akiihito/expresslrs_realtime_recorder/hardware/README.md

# 回路図 / 基板（KiCad 9）

`recorder.kicad_pro` を KiCad で開く。KiCad無しで見る／印刷する用に
`recorder.pdf`（回路図）と `pcb-fab.pdf`（基板の表面・1:1）。

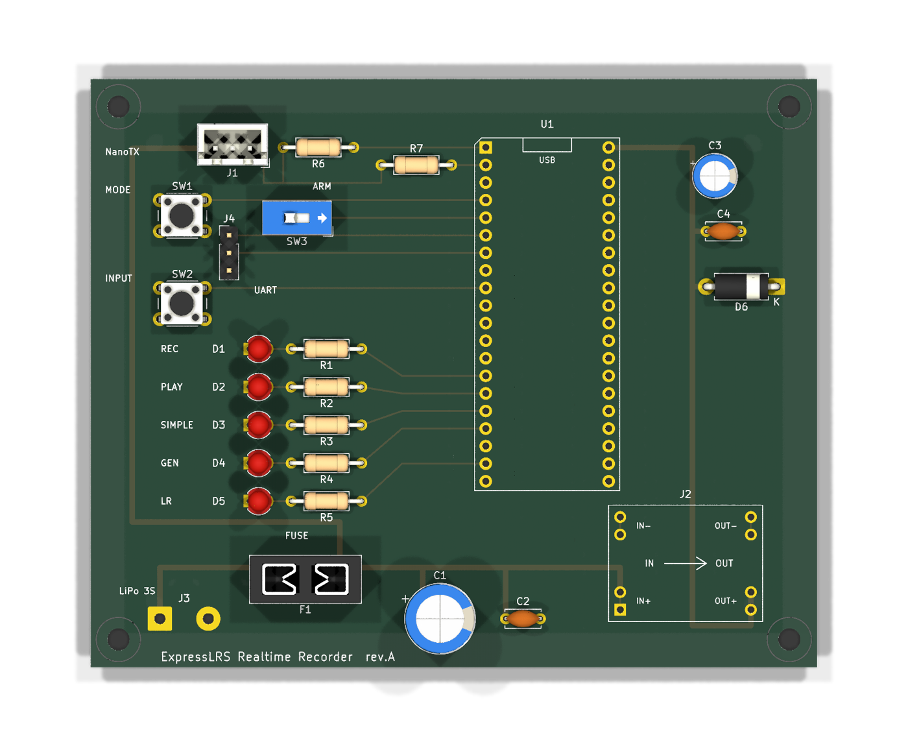
[picture p1: hardware/pcb-top.png]
基板


## 基板の概要

- **105 × 85 mm / 2層 / 全てスルーホール**（初めての基板をハンダ付け1工程で組めるように）
- **裏面は全面GNDベタ**。全部品がスルーホールなのでGNDパッドはベタに直結し、
  GND用の配線もビアも1本も無い。表面の信号配線は**ビア0**。
- Picoの**左列に繋がる部品は左側、右列(VBUS)は右側**に置き、Picoを跨ぐ配線を無くした。
  さらに左側の部品は**Picoのピンと同じY座標**に並べてあるので、配線は水平一直線で
  交差しない。

## 検証状況

| 対象 | 結果 |
|---|---|
| 回路図 ERC | **エラー0 / 警告0** |
| ネットリスト | 全ネットの結線を目視ではなく機械的に突き合わせ済み |
| 基板 DRC | **違反0 / 未配線0**（ゾーン塗りつぶし後） |
| ガーバー出力 | 正常（`kicad-cli pcb export gerbers`） |

生成スクリプトは配線の端点が「同ネットのパッド上」か「同ネットの別配線上」の
どちらかであることを出力前に自己検査する（座標の打ち間違い防止）。

> ⚠️ **実基板は未発注・未検証**。ブレッドボードで動作確認済みの回路を起こしたもので、
> DRCが通っていることと実際に動くことは別。発注前に下記「発注前チェック」を必ず実施。

## ネット一覧（`kicad-cli sch export netlist` の結果）

| ネット | 接続先 |
|---|---|
| `+5V` | J2.3 (Buck OUT+) — U1.40 (VBUS) — C3 — C4 — D6 |
| `VBAT_7_13V` | F1 (ヒューズ出力) — J2.1 (Buck IN+) — J1.3 (Nano TX VBAT) — C1 — C2 |
| （J3.1〜F1） | LiPo+ はヒューズ F1 を通ってから VBAT_7_13V へ |
| `GND` | 全GND（Pico 8本, J1〜J4, SW1〜3, D1〜D5） |
| `CRSF_TX` | U1.1 (GP0) — R6.1 (680Ω) |
| `CRSF_BUS` | R6.2 — J1.1 (Nano TX CRSF) — R7.1 |
| （R7〜GP1） | GP1 は保護抵抗 R7(1kΩ) を介してバスへ |
| `DBG_TX` / `DBG_RX` | U1.6 (GP4) / U1.7 (GP5) — J4.1 / J4.2 |
| `BTN_MODE` | U1.4 (GP2) — SW1 |
| `BTN_INPUT` | U1.9 (GP6) — SW2 |
| `SW_ARM` | U1.5 (GP3) — SW3 |
| `LED_REC` / `LED_PLAY` / `LED_SIMPLE` | U1.14/15/16 (GP10-12) — R1/R2/R3 |
| `LED_GENERIC` / `LED_LITERADIO` | U1.17 (GP13) / U1.19 (GP14) — R4 / R5 |

## ブレッドボードとの違い（要判断）

- **GP1 を CRSF バスに接続している。** ブレッドボードでは GP0 のみ配線して
  Stage D に合格したが、ファームの `crsf_drain_telemetry()` は「半二重で自分の
  送信エコーがRXに入る」前提で書かれており、参照図（63bit氏 R63b）も TXD/RXD を
  1本に結線している。基板ではその形に合わせた。**不要なら J1.1 と GP1 の間を
  切れるようにしておくと安全。**
- **SW3（GP3 の Arm トグルスイッチ）を載せている。** ファーム側の実装は
  commit `1534582` にあるがスイッチ未購入のため revert 中（`eb4c241`）。
  基板には場所を用意しておく方が後で楽なので含めた。

## 部品

PCB版・ユニバーサル基板版で共通（同じ参照記号・同じ部品を使う）。
**寸法とピッチはPCBのフットプリント＝実物の寸法**なので、買う時はこの列を見ること。
「秋月」列は秋月電子通商の販売コード（6桁の新形式。旧 `P-xxxxx` ではない）で、
**2026-10-27 にカタログで確認**した。`—` は秋月に無いもの。

| 参照 | 個数 | 買うもの | 秋月 | 寸法・ピッチ | 備考 |
|---|---|---|---|---|---|
| U1 | 1 | Raspberry Pi Pico（**ヘッダ付きの Pico H** が楽） | — | 2×20 / 2.54mm | メスヘッダに載せる想定（書込み時に外せるように）。USBポートはゲームパッド専有 |
| R1–R5 | 5 | カーボン抵抗 1/4W **100Ω** | `125101` | 軸型・足間10.16mm（2.54mm×4） | LED直列。緑/青はVf≈3Vで330Ωでは暗い。約13mAなので気になれば150Ω。100本袋しか無い |
| R6 | 1 | カーボン抵抗 1/4W **680Ω** | `125681` | 同上 | CRSF半二重バスの保護（衝突時の電流制限） |
| R7 | 1 | カーボン抵抗 1/4W **1kΩ** | `125102` | 同上 | GP1の保護。J1逆挿し時に13Vが直でGPIOへ入るのを防ぐ |
| D1 | 1 | **3mmφ** LED **赤** | `112608` | φ3.0・足2.54mm | RECORD |
| D2 | 1 | **3mmφ** LED **緑** | `111635` | 同上 | PLAYBACK |
| D3 | 1 | **3mmφ** LED **青**（秋月は青緑505nmで代用） | `112719` | 同上 | SIMPLE。⚠️ 3mmの純青は秋月では100個入りしか無い。5mm青でも手組みなら足は2.54mmで入る |
| D4, D5 | 2 | **3mmφ** LED **任意色**（黄を想定） | `111639` | 同上 | 入力プロファイル表示。赤緑青はモード表示で使い切っているので別の色にする |
| D6 | 1 | 双方向TVSダイオード **P6KE6.8CA**／秋月は **P4KE6.8CA**(400W, standoff 5.8V) | `129631` | DO-15軸型・足間10.16mm | 5Vレール。Buck短絡故障・活線挿抜サージ対策。双方向なので極性不問。⚠️ **SMD品(SMAJ5.0CA等)はこの基板に載らない**。型番の数字は降伏電圧なので「5V品」は存在しない（standoffが5.5〜5.8V＝5Vレール用） |
| SW1, SW2 | 2 | **6mm角** 基板用タクトスイッチ（4本足） | `103647` | 6×6mm・足間6.5×4.5mm | モード切替 / 入力切替。内部プルアップ使用。**対角の2本**を使う（同じ側の2本は内部で繋がっている）。⚠️ 足間が2.54mmの倍数でないので、手組みでは7.62×5.08mmに曲げて挿す |
| SW3 | 1 | 基板用 **スライドスイッチ SPST**（1回路2接点） | `115707` | 基板は7.62mm・2端子 | Arm。位置が目視できれば形状は自由（本文では「トグルSW」とも呼んでいる）。**部品待ち**。⚠️ 秋月のSS-12D00G3は3端子2.5mmピッチで**PCBのフットプリントには合わない**（手組みなら中央＋片端の2本を使えば可） |
| J1 | 1 | **JST XHコネクタ 3P**：ベース／ハウジング／コンタクト | `112248`／`112256`／`112264` | 2.5mmピッチ | Nano TX V2（背面視 左から CRSF/GND/7-13V）。**キー付きにする**（逆挿しで最大13VがCRSF線に乗る）。コンタクトは10個入り |
| J2 | 1 | **MP1584EN** 可変降圧モジュール | — | 22.3×16.8mm / 穴間隔18.9mm | **Amazon/AliExpress**（秋月に無い）。穴が2.54mmの倍数でないので手組みではリード線で接続。⚠️ 繋ぐ前に単体で5.0Vに調整 |
| J3 | 1 | LiPo側コネクタ付きピグテール（**XT30**が有力・実機で要確認） | — | 基板は足間7mmの直付けパッド | **ホビーショップ/Amazon**。**送信側（地上側）の電源で、機体に積むパックとは別物**。3Sで確定（2026-10-27）。手持ちのパックとコネクタを揃えれば充電器を共用できる。⚠️ **極性キー付きのものだけ**使う。ネジ端子・素のピンヘッダは不可 |
| J4 | 1 | 2.54mm ピンヘッダ 1×40（切って使う） | `100167` | 2.54mm | USB-シリアル変換（TXD/RXD/GND） |
| F1 | 1 | ヒューズホルダ＋**2A**ヒューズ | 下記参照 | 下記参照 | LiPo+主線。**定格は実測して決める**（2Aは初期値）。⚠️ **遅動(タイムラグ)品が秋月で確認できていない** — 速断型は投入時の突入電流で飛ぶ恐れがある（`107130` は B種とだけ表記）。ホルダの選択肢は下表 |
| C1 | 1 | 電解コンデンサ **470µF/25V** | `117883` | φ10mm・足間5.0mm | Nano TX VBAT直近。送信バーストの電圧ドロップ対策。⚠️ 秋月品はφ8mm/3.5mmピッチなのでPCBでは足を少し広げる |
| C2, C4 | 2 | セラミックコンデンサ **100nF(0.1µF)** | `112670` | φ5mm・足間5.0mm | 高周波側。C2はJ1近く、C4はPicoのVBUS近く。⚠️ 秋月品は2.54mmピッチなのでPCBでは足を広げる |
| C3 | 1 | 電解コンデンサ **100µF/16V** | `105002` | φ6.3mm・足間2.5mm | Pico VBUS直近。ゲームパッド接続時の突入電流対策 |
| H1–H4 | 4 | M3ネジ・ナット・スペーサ | — | 穴φ3.2mm | 取付穴（PCB版のみ） |

⚠️ 電解コンの耐圧は**3S満充電12.6Vを超えること**（C1は25V品）。極性に注意。
C1〜C4は回路図上は電源ラベルで繋いでいるだけなので、**PCBでは必ず対象の直近に配置**すること

#### F1 ヒューズホルダの選択肢（2026-11-03 にデータシートで確認）

| 方式 | 秋月 | 足のピッチ・太さ | PCB版 | ユニバーサル基板版 |
|---|---|---|---|---|
| ミニ平型（基板図のフットプリント） | `118222` ¥480＋ヒューズ | φ1.78mm・9.92×3.4mm | ◎ そのまま | ✗ 穴に入らない |
| ガラス管ミゼット用クリップ **2個で1組** | `110521` ×**2** ＋ `107130`(5.2×20mm 2A) | φ1.7mm・足間6.7mm | △ フットプリント別途 | ✗ 穴に入らない |
| **配線用（インライン）** | — | 線のまま | — | ◎ **手組みはこれ** |

ユニバーサル基板の穴はφ約1mmなので、**基板取付品はどちらも挿さらない**（ピッチも
2.54mmの倍数でない）。手組みでは配線用ホルダを LiPo+ の線に割り込ませる
（[`docs/perfboard.html`](../docs/perfboard.html) の「部品ごとの注意」参照）。
ミニ平型のヒューズ本体は**カー用品店の自動車用ミニ平型2A**が入手しやすい。

（離して置くと効果がない）。

### ユニバーサル基板で組む場合の追加品

| 買うもの | 秋月 | 備考 |
|---|---|---|
| ユニバーサル基板 | `113156` | 両面スルーホール 8cm×12cm。必要な穴数は [`docs/perfboard.html`](../docs/perfboard.html) 参照。7cm×9cm（`113155`）はジャストサイズ。⚠️ **カタログ寸法と穴数は別物**で、秋月もサンハヤトも穴数を公表していない（95×72mmで30×25穴の製品が実在する）ので、サイズだけで選ばないこと |
| ピンソケット **1×20** を**2本** | `103077` ×2 | U1を抜き差しできるように（書込みのたびに外す）。⚠️ **2×20品は使えない** — Picoの2列は17.78mm(7穴)離れているので、2.54mm間隔の2列品では入らない |
| 配線用ヒューズホルダ＋2Aヒューズ | — | F1。基板取付品は穴に入らないので手組みはこちら（上記「F1 ヒューズホルダの選択肢」）。カー用品店／Amazonのミニ平型インラインホルダが手早い |
| 配線材（信号） | `109583` | ポリウレタン銅線 2UEW 0.29mm 20m。**28区間のうち18区間が被覆必須**で、その大半がこれ（[`docs/perfboard.html`](../docs/perfboard.html)「配線リスト」の「線」列） |
| 配線材（裸線） | — | **すずメッキ線 φ0.6mm**。GND母線6本と、配線5区間。⚠️ **母線は抵抗の切った足では足りない** — Cは23穴=58mm、Fは24穴ある |
| 配線材（電源） | — | **AWG24程度の被覆線**。5区間（VBAT 4本とヒューズ前のLiPo+） |

**秋月ぶんの概算は約¥1,430**（2026-10-27時点・Pico/Nano TX/ゲームパッド/LiPoを除く）。
抵抗が100本袋単位なので、その¥400が効いている。

上表の J1〜J4 は、手組みでは2.54mmピンヘッダで代用してもよい（J1だけは逆挿し対策で
キー付きコネクタを推奨）。J2とF1は足のピッチが2.54mmの倍数でないので、どちらにせよリード線になる。

## 再生成について

`tools/gen_sch.py` が KiCad 標準ライブラリからシンボルを取り出して
`recorder.kicad_sch` を生成する（配線はネットラベル方式）。

```bash
cd hardware/tools && python3 gen_sch.py ../recorder.kicad_sch
```

⚠️ **再生成すると KiCad の GUI で加えた編集は失われる。** 一度 KiCad で
編集を始めたら、このスクリプトは「どう作ったかの記録」として扱うこと。

## 設計レビューで挙がった注意点（2026-08-27）

回路図を一通り見直して出た項目。**対策済み**と**運用/レイアウトで対応**に分かれる。

### 対策済み（部品を追加した）

| 想定する故障 | 対策 |
|---|---|
| LiPoショート → 発火 | **F1** ヒューズ（LiPo+主線） |
| TX送信時の電圧ドロップ | **C1/C2**（VBATレール） |
| ゲームパッド接続時の突入電流 | **C3/C4**（5Vレール） |
| Buck短絡故障で12Vが5Vへ／活線挿抜サージ | **D6** TVS |
| J1逆挿しで13VがGP1直撃 | **R7** 1kΩ（GP0側は既存のR6 680Ω） |

### ⚠️ 部品では解決できない・運用で守る項目

- **J3(LiPo)の逆接続**。回路的な逆接続保護は入れていない。ただし標準的なLiPoコネクタ
  （XT30/XT60, Deans, JST-RCY, PH2.0/BT2.0 等）はすべて極性キー付きで、**差し込む時点で
  逆にはならない**。残るリスクは**基板側の実装ミス**（コネクタを逆向きにハンダ付けする、
  ピグテールの赤黒を逆に配線する）のみ。
  - 対策: **初回通電前にテスターでJ3の極性を確認**する。ここだけは目視ではなく実測。
  - 極性キーのないもの（ネジ端子・素のピンヘッダ）は使わない。
- **J1(Nano TX)の逆挿し**。3ピンで、逆に挿すとVBAT(最大13V)がCRSF線に乗る。
  R6/R7で電流は制限されるがGPIOには良くない。**キー付きコネクタにして、
  シルクに向きを大きく印刷**すること。
- **D6はPicoの延命を保証しない**。TVSのクランプ電圧(P6KE6.8CAで約10.5V)はPicoの絶対最大定格
  5.5Vより高いので、Buck短絡時にPicoは壊れる可能性が高い。D6の役目は
  「12Vが載り続ける状態を断ってヒューズを飛ばす」こと。
- **F1の2Aは暫定値**。実消費電流を測ってから決めること（測り方は下記）。
  過大だと保護にならず、過小だと送信時に飛ぶ。
- **LEDの電流は約13mA**（赤, 100Ω）で、RP2040のドライブ設定(既定4mA/最大12mA)を
  わずかに超える。パッドの電圧が垂れて自己制限されるため実用上は問題なく、
  ブレッドボードでも動作しているが、気になるなら150Ωへ。

### 実測が必要な項目（レイアウト前に確定させる）

| 項目 | 理由 |
|---|---|
| ~~送信側LiPoのセル数~~ | **決着（2026-10-27）: 3S**。2Sは放電末期に7VでNano TXの下限に触れる。満充電12.6Vも上限13Vの内側で、ブレッドボードで使ってきた12V電源装置とほぼ同じ条件になる |
| **LiPo側コネクタの型** | J3のフットプリント選定に必要。3Sパックを買う時に決まる（XT30想定）。手持ちパックに合わせるかは運用の判断で、電気的には極性キー付きなら何でもよい |
| **降圧モジュールの実寸・ピッチ** | 同型番でも製品差がある。ノギスで実測 |
| **地上側の消費電流** | F1のヒューズ定格を決めるため（下記） |

#### 消費電流の測り方 → ヒューズ定格

> ⚠️ **「Arm時」で測るのは誤り**。Armで増えるのは*機体側*のモーター電流で、機体の
> バッテリーから出ている。F1が守るのは**地上側（Pico＋Nano TX）**で、こちらはArm状態に
> 関係なく常時500Hzで送信しているため電流はほぼ一定。

支配的なのは **Nano TXの送信出力設定**（25mW〜1000mW）。次いでゲームパッドの消費とLED。
なので測るのは「**実際に使う設定での最大**」。

- **一番簡単**: ブレッドボード検証で使っている**安定化電源の電流表示を読む**。
  回路を切らずに済む。12Vを入れ、機体とリンクさせた状態で読む。
- **テスターの場合**: 電流モード（**10Aジャック**。mAジャックはテスター内蔵ヒューズが飛ぶ）で
  **LiPo+の線に直列**に入れる。まさにF1が入る位置。

測る条件: ①TXのみ ②ゲームパッド接続＋LED点灯 ③**TX出力を実際に使う最大**に設定。

定格は測定した最大の **1.5〜2倍**を標準値から選ぶ。**遅動(スローブロー)を選ぶこと** —
Buck入力コンデンサへの突入電流で、速断型だと投入のたびに飛ぶ恐れがある。

テスターもPSUも平均値表示だが、**ヒューズは熱で切れるので瞬間のピークでは飛ばない**。
平均値＋余裕で選べばよい。

> ⚠️ **電源装置が繋がっている今のうちに測る**。LiPoに移ってからだとテスターを直列に
> 入れる手間が増える。1回の測定で**ヒューズ定格とパック容量（電流×飛行時間×余裕）**が
> 同時に決まる。

#### 電源装置からLiPoに移る時が、F1が必要になる瞬間
電圧は3S（満充電12.6V）で12V電源装置とほぼ同じだが、**電流の出方が違う**。

- **電流制限が無くなる**。電源装置には制限があるので、配線ミスでショートしても頭打ちに
  なって守られていた。LiPoは内部抵抗が低く**数十A出る**。F1が「あった方がいい部品」から
  **必須部品**に変わるのはこの切り替えのタイミングで、それ以前のブレッドボード検証で
  問題が出ていなかったことは根拠にならない。
- **突入電流が大きくなる**。Buck入力コンデンサを充電する瞬間の電流がPSUより大きく出る。
  これが上記「遅動を選ぶこと」の理由。

### PCBレイアウト時に効く項目

- **裏面はGNDベタ**にする（スター結線を線で再現しない方が良い。詳細はCLAUDE.md参照）。
- **C1/C2はJ1の足元、C3/C4はU1のVBUSピンの足元**に置く。離すと効果が消える。
- **VBAT/+5V/GNDは太いトラック**（`recorder.kicad_pro` の `Power` ネットクラス 0.8mm）。
- **テストポイントを置く**: +5V / VBAT / GND / CRSF。デバッグが楽になる。
- **U1のUSB端子は基板端へ**。ゲームパッドのケーブルが挿さる向きに。
- **取り付け穴**を忘れない。

## 発注前チェック（必須）

### ⚠️ 実測で確定させる項目（部品が手元に戻ったら）

| 項目 | なぜ必要か |
|---|---|
| ~~降圧モジュール~~ | **対応済み**。購入品 MP1584EN 用のフットプリントを作成（下記） |
| **LiPoコネクタ** | J3は**ピグテールを直付けするパッド**にしてある。送信側は3S（XT30想定）。XT30等をコネクタで付けたい場合はJ3を差し替え |
| **ヒューズ定格** | F1はミニ平型ヒューズホルダ。定格は実測して決める（本文の測り方参照） |
| **SW1/SW2 の内部結線** | ⚠️ 下記。発注前にテスターで確かめる |

#### ⚠️ SW1/SW2 は「どの2本が内部で繋がっているか」を発注前に実測する

フットプリント `SW_PUSH_6mm` は **6.5mm離れた2本が同一端子**（pin1=(0,0)と(6.5,0)、
pin2=(0,4.5)と(6.5,4.5)）という前提で、PCBはその組を銅箔で繋いでいる。
**実物が逆（4.5mm側が同一端子）だと、挿した瞬間に2端子が短絡して「常時押されている」基板になる。**
フットプリントが6.5×4.5mmの長方形なので90°回しても逃げられない。

買ったスイッチの4本をテスターで当たり、**6.5mm離れた2本が常時導通**していることを
確認してから発注する。逆だった場合は `tools/gen_sch.py` のフットプリント指定を
`SW_PUSH_6mm_H5mm` 系の合うものに差し替えて再生成する。

> 手組み（ユニバーサル基板）では**対角の2本を使うので、どちらの向きでも問題にならない**。
> これが効くのはPCB版だけ。

### 手順

1. **`pcb-fab.pdf` を1:1で印刷し、実物の部品を載せて合わせる。**
   フットプリント違いは基板を1枚無駄にする最大の原因。**特にJ2**（寸法は商品写真からの
   画像解析であり、ノギス実測ではない）。8つの穴が実物と合うかを最優先で確認すること。
2. KiCadで **3Dビュー**を開き、部品の干渉とコネクタの向きを確認。
3. **DRCを製造業者の規格に合わせて再実行**（`recorder.kicad_pro` には
   最小クリアランス0.2mm / 最小線幅0.2mm を設定済み。JLCPCB等の標準で通る値）。
4. ガーバー出力:
   ```bash
   kicad-cli pcb export gerbers --output gerber/ hardware/recorder.kicad_pcb
   kicad-cli pcb export drill   --output gerber/ hardware/recorder.kicad_pcb
   ```

### 組み立て時の注意

- **J3の極性は初回通電前にテスターで実測**（コネクタは逆挿しできないが、実装ミスは起こる）。
- **電解コン(C1/C3)とLED(D1-D5)、TVS(D6)は極性あり**。シルクの向きに従う。
- **Picoの向き**: フットプリントのシルクに `USB` と角の面取りで pin1 側を示してある。
- Picoはメスヘッダに載せる想定（書き込み時に外せるように）。

## J2: MP1584EN 降圧モジュールのフットプリント

購入品（22.3×16.8mm、4隅に2穴ずつの計8穴）に合わせて `recorder.pretty/MP1584EN_Module`
を自作した。**寸法は商品写真を画像解析して求めた実測値**:

| 項目 | 値 |
|---|---|
| 基板サイズ | 22.3 × 16.8 mm |
| 穴の左右位置 | 中心から ±9.45 mm（測定値 9.35 / 9.52 の中間） |
| 穴の上下位置 | 中心から ±6.70 / ±4.16 mm（ペア間隔 2.54mm） |
| 穴径 / パッド | 1.0 / 1.7 mm |

ピン配置（**部品面から見て**）:

```
   IN-  ┌──────────────┐  OUT-
        │  IN  ──→ OUT │
   IN+  └──────────────┘  OUT+
```

裏面シルクは `OUT-(左上) IN-(右上) OUT+(左下) IN+(右下)` で、裏返すと左右が
入れ替わるため上記になる。部品面の ⊖/⊕ 表記が出力側にあることとも一致する。
回路図シンボル(Conn_01x04)との対応は `1=IN+ 2=IN- 3=OUT+ 4=OUT-`。

> ⚠️ **ノギスでの実測はしていない。** 誤差は最大0.1mm程度と見積もられ、穴径1.0mmなら
> 吸収できるはずだが、**発注前に `pcb-fab.pdf` を1:1印刷して実物を載せ、8穴が合うことを
> 必ず確認すること**。ズレていれば `tools/gen_buck_fp.py` の PAD_X / PAD_Y_OUT を
> 直して再生成する。

## 基板の設計判断

- **GNDはスター結線ではなくベタ**。CLAUDE.mdの「LiPo−起点のスター結線」は
  細い電線で組む前提の話で、基板ではベタの方がインピーダンスが桁違いに低く確実。
- **コンデンサは対象の直近に配置**: C1/C2はJ1(Nano TX)の足元、C3/C4はPicoのVBUSピンの
  足元。回路図上は等価でも、効果はレイアウトで決まる。
- **電源は太線(0.8mm)**、信号は0.25mm。
- **+5Vは基板を縦断する長い配線**（降圧モジュール→Pico VBUS, 約65mm）だが、
  0.6Aで電圧降下は約20mVなので問題ない。電流の大きいVBAT側を短くする配置を優先した。
- **J2は右下に配置**。VBAT(大電流)を短く、+5Vを基板縦断にする方針に加え、
  モジュール本体(22.3×16.8mm)がPicoと取付穴のどちらとも干渉しない位置がここだった。
- **U1のUSB端子は基板端から約8mm内側**。Picoはヘッダで約8mm持ち上がるのでケーブルは
  基板をまたげるが、気になるなら基板上端を数mm削ってもよい。

## 再生成について

```bash
cd hardware/tools
python3 gen_sch.py ../recorder.kicad_sch                      # 回路図
kicad-cli sch export netlist --format kicadsexpr -o net.net ../recorder.kicad_sch
python3 gen_pcb.py net.net ../recorder.kicad_sch ../recorder.kicad_pcb   # 基板
/Applications/KiCad/KiCad.app/Contents/Frameworks/Python.framework/Versions/3.9/bin/python3 \
    fill_zones.py ../recorder.kicad_pcb                       # ゾーン塗りつぶし
python3 gen_perf.py net.net ../../docs/perfboard.html         # ユニバーサル基板版
```

⚠️ `docs/perfboard.html` は `gen_perf.py` の出力。**HTMLを直接編集しても次の再生成で消える**ので、
直すときは `gen_perf.py` を直してから再生成すること。

⚠️ **再生成するとKiCadのGUIで加えた編集は失われる。** 一度GUIで編集を始めたら、
これらのスクリプトは「どう作ったかの記録」として扱うこと。

※ `kicad-cli` にはゾーンを塗る機能が無いため、塗りつぶしだけKiCad同梱のPython
(`pcbnew`)を使っている。塗らないとDRCがGNDを未配線と報告する。
