akiihito/expresslrs_realtime_recorder/docs/breadboard-bringup.md

# ブレッドボード段階的ブリングアップ手順

ブレッドボードでサブシステムごとに切り分け検証し、最後にユニバーサル基盤へ移設する。
各 Stage は**前段が緑になってから**進むこと。**プロペラは終始外す**。

前提機材（本セッションで確定）:
- 給電: **安定化電源(PSU)**。電流制限を効かせ、Buck誤設定によるPico破壊を回避。LiPo+BuckはStage Fで導入。
- CRSF切り分け: **オシロスコープ**（GP0波形・反転極性・ボーレートを直接確認）。
- ゲームパッド: **汎用HIDパッド**（決め打ちパーサ。Stage Cで実機バイト配置を確認・調整見込み）。

詳細な単票チェックは `hardware-validation.md` を参照。本書はそれを段階順に割り当てたもの。

---

## Stage A — 電源のみ（過電圧でPico即死を防ぐ）

目的: Picoに正しい5.0Vだけが入ることを、Pico接続前に確定する。

1. [x] PSU出力を **5.0V / 電流制限 ~0.7A** に設定し、**テスターで実測**。
2. [—] （Buckを使う場合のみ）Buck OUT+ を**テスターで実測5.0V**に調整。可変品は初期12V等がある。→ 今回はPSU直、Buckは Stage F で導入。
3. [x] 極性確認: OUT+ → Pico **VBUS(pin40)**、OUT− → Pico **GND(pin3)**。**VSYSではない**。
4. [x] Pico単体を接続（ゲームパッド・TX・LED未接続）。PSU電流が数十mA程度で安定（突入後）。
5. [x] 内蔵LEDが点灯 or 点滅（ファーム次第。未書込なら消灯でOK）。異常発熱が無いこと。

> ✅ 合格条件: VBUSに5.0V±0.1、過大電流/発熱なし。

**実施記録 (2026-07-16): 合格。** VBUS実測≒5.0V、消費電流 0.02A(20mA) で安定、発熱なし。

---

## Stage B — モードUI（ファーム＋UART＋LED＋ボタン、無線なし）

目的: ファームのUIロジックと GP2/GP10-12 配線を、ゲームパッド・TXなしで検証。

配線追加: GP4→USB-シリアル変換RXD（GND共通）、GP2→タクトSW→GND、GP10/11/12→LED→100Ω→GND。

1. [x] 書込: ゲームパッド・外部5Vを外し、BOOTSEL押しながらmicro-USB接続 → `./scripts/flash.sh` → 配線復帰。
2. [x] `./scripts/monitor.sh`（921600bps）で起動バナー・`Mode: SIMPLE`・`signal inversion: ON` を確認。
   → **⚠️ 手元のFTDI変換器では `./scripts/monitor.sh 115200` を指定しないと化ける**（下記「既知の問題」）。
3. [x] `?` でコマンド一覧が返る。
4. [x] 起動直後 **青LED(GP12=SIMPLE)** 点灯。
5. [x] 短押しごとに `# mode -> RECORD/PLAYBACK/SIMPLE`、LEDが **赤→緑→青** と移る。
   - 2026-10-20以降: RECORDの赤は**ゆっくり点滅**（待機）、PLAYBACKの緑は**点灯**（待機）。
6. [x] RECORD中に `r` を送ると `# recording START` で赤が**点灯**、もう一度で `# recording STOP`。
   （ベンチではゲームパッドが無いので、LBの代わりにUARTの `r` で試す）
   → 2026-10-20 はゲームパッドのLBで確認した。`r` 経路は同じ `recording_toggle()` を呼ぶ。
7. [x] PLAYBACK中に**長押し(0.6s)** → 記録済みなら `# playback START` で緑が**点滅**に変わる。
   → **✅ 2026-10-20 確認。**
   - [ ] フラッシュが空のとき `# playback not started: no log in flash` で**開始しない**
     （緑は点灯のまま）→ **未確認**。確認時はフラッシュにログが入っていたため試せていない。
   - ⚠️ 2026-10-20より前は「データ無しでもトグルログが出る」挙動だった。空で開始すると
     緑が点滅して再生中に見えるのに何も送出されず表示が嘘になるため、開始しないよう変えた。
   - ⚠️ 2026-10-20より前は「データ無しでもトグルログが出る」挙動だった。空で開始すると
     緑が点滅して再生中に見えるのに何も送出されず表示が嘘になるため、開始しないよう変えた。

> ✅ 合格条件: 3モード循環・LED対応・短長押し判定が全て一致。

**実施記録 (2026-07-16): 合格。**
- モード循環・長押し判定ともログで確認、LED3個の点灯もモード名と一致することを目視確認済み（1ピンずれ修正後）。おまけに記録→再生フローが一巡した:
  `# mode -> RECORD` → `# recording started` → `# mode -> PLAYBACK` → `# recording stopped, flushed 137 samples to flash`
  （⚠️ `# recording started` は**当時の文言**。現在は LBトリガー化に伴い `# recording START (buffer cleared)` に変わっている）
  → `# playback ready: 137 samples` → 長押しで `# playback START (137 samples)` → `# playback finished`
- 137サンプル ÷ 50Hz = 2.74秒 で、ログのハートビート(1秒毎)間隔と一致。**再生レートが設計どおり**であることを確認。

### ハマった点（次回の切り分け用）
- **タクトSWの向き**: 4本足の同じ側2本は内部で短絡済み。90°回して挿すとGP2がGND常時短絡＝無反応になる。**対角の2本**を使う。
- **ピンの数え間違い**: LED3本を pin14/15/16 のつもりで pin13/14/15 に挿し、1本目がGND(pin13)で点灯せず。手元のPicoは **pin20(GP15)にヘッダが無い**ため下から数えるとずれる。**GND(pin3/8/13/18/…、5ピンおき)を基準に数えること**。

### 既知の問題（未解決）
**デバッグUARTのボーレートが8倍ずれて見える。** 手元のFTDI変換器(`/dev/cu.usbserial-A5069RR4`)では `monitor.sh 115200` でのみ正しく読める。
- ファーム側は正常と確認済み: 逆アセンブル上 `stdio_uart_init` は `uart_init(uart1, 0xE1000=921600)` を呼び、GP4/GP5 も正しい。ソースに `set_sys_clock` 等のクロック変更は無い。
- よって**変換器の分周器バグ（FT232R偽物チップ）が犯人という仮説が有力**だが未確定。
- **Stage Dでオシロを出すときに GP4 のビット幅を測って決着させること**: **1.09µs なら921600**（＝変換器が犯人・実害なし、monitor.shに115200を渡し続ければよい）、**8.68µs なら115200**（＝ファーム側の問題。25Hzストリームの1行が1.4ms→11msに膨張し500Hz送信を破壊するため、Stage C/Dの前に要修正）。

---

## Stage C — ゲームパッド（USB Host / HIDパーサ確定）

目的: 汎用パッドの生HIDレポートから軸/ボタンのバイト配置を確定し、必要ならパーサ調整。TXはまだ繋がない。

配線追加: ゲームパッド ─OTG(micro-B→A)→ Pico micro-USBポート。（書込用ポートと共用のため、以降の書込は都度パッドを外す）

1. [ ] SIMPLEモードでパッドを操作しつつ `d`（スナップショット）。
2. [ ] `(1) HID raw` が全0でない。**VID/PID を控える**。
3. [ ] 各スティック/ボタンを個別に動かし、`(1)`のどのバイトが変化するか対応表を作る。
4. [ ] `(2) state` のスティック値、`(3) CRSF ch` が操作に追従（172〜1811、CH3=throttle最小で172付近）。
5. [ ] `(5) frame` 末尾 CRC が **OK**。
6. [ ] **ズレる場合**: `src/usb_gamepad.c` の `process_gamepad_report()` を実機バイト配置に合わせて調整・再ビルド・再書込。

> ✅ 合格条件: 全スティック/主要ボタンが期待するCRSF chに正しくマップされCRC OK。
> 記録: VID/PID、バイト配置、パーサ調整の有無を `hardware-validation.md` 記録テンプレへ。

**実施記録 (2026-07-17): ❌ 未合格 → (2026-07-18): ✅ 原因判明・ワークアラウンドで解決。**
（以下の 2026-07-17 の調査履歴は原因特定までの経緯。結論は直後の「続報 (2026-07-18)」を参照）

---
### 続報 (2026-07-18): ✅ 解決 — 原因は RP2040 のチップバグ + F310 の DATA1 開始

**まず Full Speed は無罪だった。** 対照デバイス EM01NL（Full Speed）が正常にレポートを返した
（最初の1回は沈黙したが、それは**マウス側の一時不具合**で、挿し直したら動いた）。
→ **問題は F310 固有**と確定。

**動く EM01NL と動かない F310 を debug2 で比較**して差分を2つに絞った:
| | EM01NL(動く) | F310(動かない) |
|---|---|---|
| 割り込みIN maxpacket | 8バイト | **32バイト** |
| 割り込みOUT EP | なし | **あり(EP0x02)** |
| 転送 | `Queue EP82 → on EP82 with 4 bytes: OK` ✅ | `Queue EP81 →（complete来ず）` ❌ |

**真因（TinyUSB issue #2776）**: RP2040 の自動ポーリング型EPハードウェアは**データシーケンス
エラーから回復できないチップバグ**を持つ。F310 は**最初の Interrupt IN 転送を DATA0 ではなく
DATA1 PID で開始する**（F310ファーム側の癖）。RP2040 は初期PIDを DATA0 決め打ちで待つ
（`ep->next_pid = (num == 0 ? 1u : 0u)`）ため、シーケンスエラー→**EP0x81 が無限ループでフリーズ**。
→ maxpacket も OUT EP も**無関係**だった（両方とも濡れ衣）。

**ワークアラウンド（実機で成功）**: F310 の EP0x81 を開くとき初期PIDを DATA1 にする。
→ `# HID first report: len=20`、以降 8バイトレポートが連続受信（1010回/30秒）。
**軸4本すべてが CRSF ch(172〜1811)に正しく追従することを実機確認**。昨日解読した軸配置
（report[0..3]）が正しいと裏取り完了。

⚠️ **改変は SDK 内の TinyUSB を直接いじった一時状態（git管理外・要恒久化）**:
- ファイル: `$PICO_SDK_PATH/lib/tinyusb/src/portable/raspberrypi/rp2040/hcd_rp2040.c`
- 関数 `_hw_endpoint_init`（324行付近、`ep->next_pid = (num == 0 ? 1u : 0u);` の直後）に、
  `tuh_vid_pid_get(dev_addr,...)` で VID/PID を取り、**046D:C216 かつ ep_addr==0x81 なら
  `ep->next_pid = 1u`** にする数行を追加（`// ワークアラウンドここまで` で挟んである）。
- `host/usbh.h` が既にincludeされているので `tuh_vid_pid_get` はそのまま使える。

**残タスク（次回）→ 全て完了 (2026-07-18)**:
1. ✅ **ワークアラウンドの恒久化**: 選択肢(b)採用。`patches/hcd_rp2040_f310_data1.patch` と
   冪等な適用スクリプト `scripts/apply_sdk_patch.sh` を追加。SDK入れ直し後に1回実行する運用。
   （※スクリプトの冪等判定マーカーは実在文字列 `expresslrs_realtime_recorder Stage C`、
   `patch -N` で逆適用の誤爆も防止。初版はマーカー不一致でパッチを逆適用消去するバグがあり修正済み。）
2. ✅ **F310専用パーサ追加**: `process_f310_report()` を新設し VID/PID(046D:C216)で分岐。
   D-Pad(ハット)は `report[4]&0x0F`、フェイスボタンは byte4上位4bit、ショルダー等は byte5。
   **全14項目（軸を除く全ボタン＋D-Pad4方向）を実機 `d` スナップショットで全数検証・全正解**（下記）。
3. ✅ **`CFG_TUSB_DEBUG` を 2→0 に戻した**（実飛行時オーバーヘッド回避）。
4. ✅ **各ch追従＋CRC OK 確認済** → **Stage C 正式合格**。

**ボタン実機検証結果 (2026-07-18)**（中立: `HID raw = 80 7F 80 7F 08 00 00 FF`）:
| ボタン | HID実測 | BTN | CRSF |
|---|---|---|---|
| A/B/X/Y | byte4 `0x20`/`0x40`/`0x10`/`0x80` | 0x0001/02/04/08 | CH7(Arm)/8/9/10 |
| LB/RB | byte5 `0x01`/`0x02` | 0x0010/0020 | CH11/12 |
| BACK/START | byte5 `0x10`/`0x20` | 0x0040/0080 | — |
| L3/R3 | byte5 `0x40`/`0x80` | 0x0100/0200 | — |
| D-Pad ↑/→/↓/← | byte4下位4bit `0`/`2`/`4`/`6` | 0x0800/4000/1000/2000 | — |
---

**（以下 2026-07-17 の調査履歴。原因特定の経緯として保存）**

### 使用パッド: Logitech F310

裏面に **X(XInput) / D(DirectInput) 切替スイッチ**がある。

- **X モード (PID 046D:C21D)**: USBとしてはベンダー固有クラス（Xbox360プロトコル）で、**HIDではない**。TinyUSBにはHIDホストドライバしか積んでいないため、`# USB mounted` は出るが `# HID mounted` は絶対に来ない。**このモードでは原理的に動かない。**
- **D モード (PID 046D:C216)**: 標準HIDゲームパッド(Dual Action相当)として現れ、HIDドライバがマウントできる。**必ずDにしてから挿し直すこと**（スイッチを動かすだけでは反映されない）。

### 判明したこと（Dモード）

列挙は**完全に成功**する。Full Speed / EP 0x81 IN(32B, interval 4) + EP 0x02 OUT(32B) / Set Idle OK / レポート記述子99バイト取得OK / `# HID mounted` まで到達。
**しかし割り込みIN転送が一度も完了しない。** `hcd_edpt_xfer` は `OK` を返す（＝ハードは4ms毎にEP 0x81をポーリングしている）のに、パッドが応答しない。制御転送(EP0)は全て成功しているのでパッド自体は生きている。

### 対照実験

| デバイス | 速度 | 割り込みEP | 接続 | 結果 |
|---|---|---|---|---|
| マウス (056E:00FC) | Low Speed | IN 1本 | **無線(ドングル)** | ✅ レポート届く(218回) |
| キーボード (0566:3029) | Low Speed | IN 2本 | **有線** | ✅ レポート届く(50回) |
| **F310 (046D:C216)** | **Full Speed** | IN + **OUT** | 有線 | ❌ 沈黙 |

→ **USBホストスタックと割り込みIN転送自体は正常**。F310固有の問題。
→ 割り込みINが複数でも動くので**EP本数は無罪**。
→ 対照2つが**どちらもLow Speed**なのが弱点。速度差の分離ができていない。

### 否定済みの仮説
- **割り込みOUT EP(EP 0x02)の干渉**: `int_ep_ctrl` のビット2を直接落としてOUT側のポーリングを止めても**変化なし**。→ 無罪。
- **E15エラッタによる転送保留**: デバイスモード専用でホストビルドではマクロごと `false`。→ 無関係。
- **初期化ミス/`tuh_task()`未呼び**: 列挙が通る時点で否定。
- **電源不足（パッドの消費電力が大きくて動けない）**: **否定済み**。①**F310接続状態でVBUS実測4.96V**（USB規格下限4.75Vに対し余裕あり）＝パッドには正常な5Vが届いている。②PSUは制限1Aに対し実測30mA(Pico 20mA+パッド約10mA)で**電流制限に当たっていない**＝パッド自身が引いていない。③電力不足の典型症状は列挙失敗か切断ループだが、99バイトのレポート記述子取得まで完走し切断もしない。④**有線キーボードは数十mAを消費して正常動作**した。

### 残る容疑
**Full Speed**（対照2つが偶然どちらもLow Speedで、分離できていない）。ただしPico+TinyUSBでFSのHIDが全滅なら世界的に問題になるはずで、事前確率は低い。**次回はFull SpeedのHIDデバイス（ゲーミングマウス等）で対照実験するのが最優先。**

### 次回の手順（優先順）
1. **Full SpeedのHIDデバイスで対照実験** ← 本命の切り分け。**対照デバイスは確保済み**:
   **ELECOM EM01NL トラックボール**の2.4GHzドングル（`2.4G Receiver`, Compx **25A7:FA61**）が
   **Full Speed** であることをMac側で確認済み。これをPicoに挿すだけで決着する。
   - **レポートが届く** → Full Speedは無罪 → **F310固有**と確定 → 手順2(XInput)へ
   - **沈黙する** → **Full Speed全般が黒** → RP2040ホストドライバ側の問題と確定 → 追及の的が変わる
   - ※ Mac側での事前スクリーニングは `ioreg -p IOUSB -w0 -l | grep -E '"USB Product Name"|"Device Speed"'`
     （`Device Speed` は 0=Low, 1=Full, 2=High, 3=Super。`system_profiler SPUSBDataType` は空を返すので使えない）
2. **XInputドライバを入れる**（F310本来のXモードで使う。Pico+TinyUSBでXboxパッドを扱う実装は前例が多い）
3. **別のゲームパッドを試す**（動けば前進、動かなければFS全般が黒と確定できて情報量が大きい）

### 解読済み: F310(Dモード)のHIDレポート配置 ※レポートさえ届けば即対応可能
レポート記述子(99バイト)を解読した結果、**8バイト**レポートで以下の配置。

| バイト | 内容 |
|---|---|
| 0 | X = 左スティックX (0-255) |
| 1 | Y = 左スティックY |
| 2 | Z = 右スティックX |
| 3 | Rz = 右スティックY |
| 4 | **下位4bit = D-Pad(ハット, 0-7, 8=中立)**、上位4bit = ボタン1-4 |
| 5 | ボタン5-12 |
| 6-7 | ベンダー固有16bit |

→ 現行 `process_gamepad_report()` の**軸割り当て `report[0..3]` はそのままで正解**。
→ **ボタンのみ要修正**: `buttons = report[4]` だとハット値が混入する。正しくは
  `buttons = ((report[4] >> 4) | (report[5] << 4)) & 0x0FFF` 、ハットは `report[4] & 0x0F`。

### 調査の再現方法
- `include/tusb_config.h` の `CFG_TUSB_DEBUG` を **2** にすると列挙・転送が全部ログに出る。
  CMakeが `-DCFG_TUSB_DEBUG=0` を注入するので `#ifndef` ガードでは効かず、**`#undef` してから定義**すること。
- `src/usb_gamepad.c` の mount/umount/first-report ログは常設。`# HID first report: len=N` が
  出れば受信できている（マウント毎にリセットされる）。
- screenはコピペしづらいので、pyserialでファイルに落とすと速い。**この変換器では115200を指定**すること
  （8倍ずれの既知問題。Stage B参照）。TinyUSBのログはNULが大量に混じるので `replace(b'\x00', b'')` してから読む。

---

## Stage D — TX疎通（CRSF反転切り分け・オシロ活用）

目的: Nano TX V2 経由で機体までRCを通す。反転/半二重/ボーレートを確定。**プロペラ無し**。

配線追加: Pico **GP0(pin1)** → Nano TX CRSF/S.Port信号線（参照図は680Ω直列）。TX VBAT → PSU 7〜13V（別チャンネル or 別電源。Buck5VとTX+は絶対に繋がない）。

1. [x] **オシロでGP0を観測**: 送信バーストが出ているか、ボーレート≒921.6kbps、アイドルレベル（反転ON→アイドルLow）を確認。→ **✅ 完了 (2026-07-18)**、下記記録参照。
2. [x] 機体受信機を対象TXにバインド済みにする。→ **✅ 完了 (2026-08-05)** 機体は **Pavo Pico II**（Serial ELRS、ターゲット `BETAFPV 2.4GHz AIO RX`、FW 3.5.6 ISM2G4）。binding phrase方式でバインド、TX単体給電＋機体でリンク確立を確認。Nano TX V2の物理ピンは背面視・左から **CRSF / GND / 7V-13V / 残りNC**（Oscar Liangレビュー内BetaFPV公式図で確認、SMA外殻↔GND導通でも検証可）。
3. [x] SIMPLEで BetaflightのReceiverタブを開き、スティック/スイッチが追従するか確認。→ **✅ (2026-08-06)** 全軸・全ボタン追従。
4. [x] **通らない場合の切り分け**（§5）: → **不要だった**。反転ON（現行コード）のままで疎通。
5. [x] Arm(CH7=Aボタン)でモーターArm/Disarm（ペラ無し）。→ **✅ (2026-08-06)** トグル式に変更して合格（下記）。
6. [x] **反転ON/OFFどちらで疎通したかを記録**。→ **反転ON=`CRSF_INVERT_SIGNAL 1` で確定**。CLAUDE.md/コードは既に一致しており変更不要。

> ✅ 合格条件: Receiverタブで全ch追従、Arm/Disarm動作。反転極性を実機で確定。
> → **✅ Stage D 完全合格 (2026-08-06)**

**実施記録 (2026-08-06): ステップ3〜6合格、Stage D完了。** 途中で見つけた問題と対応:

- **スティック上端で値が巻き戻るバグ**: フル上で2008µs超→988µsへ飛ぶ。原因は上下反転の
  `-axes`（int16）で `-(-32768)` があふれて -32768 のままになるオーバーフロー。
  `axis_invert()`（INT16_MIN を INT16_MAX に飽和）を導入して修正・実機確認済み。
- **Armをトグル式に変更**: F310は押しボタンでArm状態を保持できないため、Aボタンの
  押下エッジで Arm/Disarm を切り替えるラッチに変更。切断フェイルセーフでラッチも
  リセット（再接続で勝手にArmが復活しない）。デバッグUARTに `# ARM`/`# DISARM` を出力。
  ⚠️ **TODO(実飛行前)**: 飛行中の誤タッチ1回で即Disarm=墜落する。
  → **方針決定済み（GP3の物理トグルスイッチへ移行。スイッチ位置=Arm状態が目視できる）**。
  実装は commit `1534582` に完成済みだが、スイッチ未購入のため `eb4c241` で revert 中。
  **入手後に `git revert eb4c241` で復活**させるだけでよい。基板(hardware/)にはSW3として
  場所を確保済み。
- **F310ボタンマッピング実機確定**: A→AUX3, B→AUX4, X→AUX5, Y→AUX6, LB→AUX7,
  RB→AUX8 で仮マッピング通り。usb_gamepad.c の警告コメントを実機確認済みに更新。
- **豆知識**: Betaflight Configurator接続中は `MSP`/`CLI` フラグでArm不可（安全機構）。
  Arm試験はUSBを抜いてから。Arm拒否時はビープで通知される。
- 切断フェイルセーフ実機確認: Arm中にパッドを引き抜き→即モーター停止、再接続で復帰。

**実施記録 (2026-07-18): ステップ1（GP0オシロ観測）✅ 完全合格。** ステップ2以降（TX結線・バインド・Receiver追従）は次回。

**実施記録 (2026-08-05): 電源系をStage F前倒しで最終トポロジに変更。** LiPoの代わりにPSU 12V（3S模擬）を使い、PSU 12V → TX VBAT直結 ＋ MP1584E降圧 → Pico VBUS の構成に。Buck出力は無負荷・12V入力で**実測5.03V**に調整済み（9〜12.6V入力振りでも安定を確認する手順で実施）。以降のStage D/EはこのPSU＋Buck構成で進める。

構成: Pico単体＋USB給電のみ（ゲームパッド/TXモジュール/バッテリー不要）。ゲームパッド未接続でも
フェイルセーフ値で500Hz送信が続くため、GP0の信号は単体で観測可能。プローブ: GP0(pin1)/GND(pin3)。
使用オシロ: OWON（安価機）。波形は `screenshot/wave1.jpg`(500µs/div) と `wave2.jpg`(5µs/div)。

| 確認項目 | 期待 | 実測 | 判定 |
|---|---|---|---|
| ① 送信バースト・周期 | 2ms間隔=500Hz | バーストが**4div×500µs=2ms間隔** | ✅ 500Hz |
| ② アイドルレベル | 反転ON→Low | ベースライン0V、パルスが**3.3Vへ立上り** | ✅ アイドルLow=反転が効いている |
| ② 振幅 | 3.3Vロジック | 基線から**約3.3div×1V=3.3V** | ✅ |
| ③ ビット幅=ボーレート | 1bit≒1.085µs | 最細パルス**≈1µs**（5µs/div, 100MS/s で分解） | ✅ 921600bps |

⚠️ **安価スコープの注意（次回の自分向け）**: 遅い時間軸(500µs/div)では**サンプルレートが1MS/sに落ち**、
1.09µsビットを1サンプル/ビットしか取れず塊にしか見えない。**5µs/div等まで速くすると100MS/sに上がり**
ビットが分解できる（100サンプル/ビット）。ビット幅を測るときは必ず時間軸を速くしてSRを上げること。
なお周波数カウンタ表示(23〜24kHz)はバースト信号では無意味（連続周期信号でないため）。

**結論**: Pico は正しいレート(500Hz)・ボーレート(921600)・極性(反転=アイドルLow)でCRSF送出中。
`CRSF_INVERT_SIGNAL 1` はピン上で正しく機能。ただし**「Nano TXが反転を要求するか」の最終確定は
ステップ3（Receiver追従）**で行う（GP0観測はあくまで「コード通りの極性が出ている」ことの裏取り）。

---

## 入力プロファイル切替（Stage D後に追加）— 実施記録 (2026-08-26)

汎用ゲームパッドの自動中央復帰スティックでスロットルを扱うため、GP6のボタンで
GENERIC(積算) ⇔ LITERADIO(絶対値) を切り替える機能を追加し、実機で確認した。**✅ 合格**。

- ボタン(GP6)・LED(GP13/GP14)ともに動作。UARTに `# input -> ...` が出る。
- 積算スロットル: CH3が 185→671→1111→1277 と増加し、**スティックを中央に戻すと508で保持**。
  中央での値の流れ無し（不感帯が機能）。ロール/ピッチ/ヨーも172〜1805で正常に追従。
- ハマった点: **GNDをpin8ではなくGP7(pin10)に挿していて無反応**だった。
  GP6=pin9 の隣の**pin8がGND**。ピンは必ずGND(3/8/13/18…)基準で数えること。
- 観測: CH2(Pitch)の中立が**998**（中央992に対し+6, 約0.4%）。実害の無い範囲だが、
  実飛行で前後に流れるようならトリムで調整する。

---

## HIDディスクリプタ解析 / LiteRadio 3 対応 — 実施記録 (2026-08-26)

VID/PID決め打ちのパーサでは未知の機種に対応できないため、HIDレポートディスクリプタを
解析して軸・ボタンのビット位置を自動で求める方式を追加（`src/hid_parser.c`）。**✅ 両機種で合格**。

**F310 (046D:C216) — 解析結果が専用パーサと一致**（パーサ自体の妥当性検証）:
`LX:bit0 LY:bit8 RX:bit16 RY:bit24 (各8bit), buttons=11@bit36, hat=yes`

**LiteRadio 3 (0483:572B) — 新規対応**: 16bit×8ch(0..2047)、報告長18B、hat無し。
ディスクリプタ順 X,Y,Z,Rx,Ry,Rz,Slider,(他)。**送信機はAETRのチャンネル順**なので
ゲームパッドのスティック解釈は当たらない。`channels[]`（ディスクリプタ順）を追加し、
LITERADIOプロファイルで CH1〜 へ素通しするようにした。

実測で確定（スティックを1本ずつ全方向に振り、25Hzストリームを記録して解析）:

| 操作 | Usage | CRSF | 実測値 |
|---|---|---|---|
| 右スティック 左/右 | X | CH1 Roll | 172 / 1811 |
| 右スティック 下/上 | Y | CH2 Pitch | 182 / 1803 |
| 左スティック 下/上 | Z | CH3 Throttle | 172 / 1811 |
| 左スティック 左/右 | Rx | CH4 Yaw | 172 / 1811 |

**対応・極性ともすべて標準配置に一致**したため、追加のマッピング修正は不要だった。

### ハマった点
- **`s` コマンドはトグル**。既にONの状態でもう一度送るとOFFになり、25Hzストリームではなく
  1Hzのハートビートしか記録されない。記録スクリプトは `D,` 行が流れるまで送り直すこと。
- 副産物: 汎用ボタンをビット順に詰めると**ボタン12以降がD-Padのビット11〜14と衝突**する
  ことをユニットテストが検出。取り込みを11個までに制限して解決。

---

## Stage E — 記録→再生・フェイルセーフ

目的: 記録フロー全体と切断時の安全動作を実機で確認。

1. [x] RECORD(赤LED **ゆっくり点滅**=待機)に入る → `# RECORD ready: press LB ...`。
2. [x] **LB**を押す → 赤LEDが**点灯**に変わり `# recording START`。数十秒操作して
       もう一度LBで `# recording STOP (N samples in RAM...)`。→ **✅ 2026-10-20 確認。**
3. [x] 短押しで抜ける → `# recording stopped, flushed N samples`（N>0）。
       LBを一度も押さなければ `# nothing recorded, flash log kept`。
4. [x] PLAYBACK(緑LED **点灯**=待機) → `# playback ready: N samples`。
5. [x] **長押し**で再生開始 → 緑LEDが**点滅**に変わる（受け付けの合図）。
       末尾で `# playback finished` と点灯に戻る。→ **✅ 2026-10-20 確認。**
6. [ ] 電源再投入後もPLAYBACKでNが残る（フラッシュ永続）。**未確認**
7. [x] フェイルセーフ → **Stage Dで確認済み**（Arm中にパッドを引き抜き→即モーター停止、再接続で復帰）。

> ✅ 合格条件: 記録→再生の一巡再現、切断で安全値、再接続で復帰。

**実施記録 (2026-10-14): 記録→再生の一巡が実機で成功。** ボタン操作だけで
RECORD→PLAYBACK→長押し再生まで通り、再生が最後まで走ることを確認した。

⚠️ **この回はシリアルを記録していないため、以下は未検証のまま**:
- `flushed N samples` の N が妥当か（50Hz記録なので N ≈ 50×記録秒数 になるはず）
- 再生された値が記録時と一致しているか（波形の突き合わせ）
- 手順6の電源再投入後の永続性

次回、シリアルを記録しながら同じ操作を1回やれば上記3点はまとめて潰せる。

**実施記録 (2026-10-20): LBでの記録start/stopと再生の緑LEDを実機で確認。合格。**
RECORD入場で赤がゆっくり点滅（待機）→ LBで点灯（記録中）→ もう一度LBで点滅に戻る →
モードを抜けてフラッシュ書出し → PLAYBACKで緑点灯（待機）→ 長押しで緑点滅（再生中）→
末尾で点灯に戻る、までが仕様どおり動いた。モード表示の赤LEDが入場直後から点滅するのは
仕様（記録していない状態）。

⚠️ **この回も以下は未検証のまま**（次回まとめて潰す）:
- `flushed N samples` の N が妥当か（N ÷ 50 = 記録秒数 になるはず）。数えていない。
- 再生された値が記録時と一致しているか（波形の突き合わせ）。シリアルログを残していない。
- 電源再投入後の永続性（手順6）
- LBを押さずにRECORDを通過した時に `# nothing recorded, flash log kept` となり
  保存済みログが残るか（手順3の後半）
- フラッシュが空のときに再生が始まらないか（Stage B 手順7）

**改善点 → 実装済み (2026-10-20)**: 「RECORDに入ってから抜けるまでが丸ごと記録されるので
記録の切れ目が分からない」「再生を開始してもLEDが変わらず、ボタンが受け付けられたか分からない」
の2点。前者は**ゲームパッドのLBで記録start/stop**（開始ごとにバッファクリア）、後者は
**緑LEDを 点灯=待機 / 点滅=再生中** に変更して対応した。赤LEDも
ゆっくり点滅=待機 / 点灯=記録中 / 速い点滅=満杯 の3状態になった。仕様は CLAUDE.md 参照。
**いずれも実機未確認**なので、次回の Stage E 再試験で上の手順2と5を埋める。

---

## Stage F — ユニバーサル基盤へ移設

目的: 検証済み回路を `docs/perfboard.html` に従いハンダ実装し、短縮版で再検証。

1. [ ] perfboard.html の配線リスト通りにハンダ。GP0直列抵抗・半二重結線はStage Dで確定した方式で。
2. [ ] **給電をLiPo+Buckへ切替**: Buck出力を**テスターで実測5.0V**に調整してからPico接続（Stage A手順を再実施）。TX VBATはLiPo直結。GNDはLiPo−起点のスター結線。
3. [ ] 導通チェック（テスター）: 電源極性、GNDスター、GP0/GP2/GP4/GP10-12 の結線とショート無し。
4. [ ] 短縮再検証: Stage B(モードUI) → C(パッド追従1点) → D(疎通・Arm) → E(記録再生1回・フェイルセーフ) を各1パス。
5. [ ] 実運用メモ更新（Buck実測電圧、最終配線、既知の注意点）。

> ✅ 合格条件: 基板単体で Stage B〜E の短縮版が全て緑。
