akiihito/expresslrs_realtime_recorder/docs/hardware-validation.md

# 実機検証手順（ブリングアップ・チェックリスト）

制御経路（ゲームパッド → Pico → Nano TX V2 → 機体）と、記録/再生・フェイルセーフを
実機で確認するための手順。**プロペラを外した状態で**行うこと。

---

## 0. 事前準備：配線チェック（通電前）

テスターで**通電前に**以下を確認する。特に電源の極性・電圧を最優先。

### 電源（最重要）
- [ ] Buck出力を **テスターで実測5.0V** に調整済み（可変モジュールは初期12V等がある）。Picoに繋ぐ前に必ず確認。
- [ ] Buck OUT+ → Pico **VBUS(pin40)**（VSYSではない）。
- [ ] Nano TX VBAT → **LiPo直結(7〜13V)**。**Buck5VとLiPo+は絶対に繋がない**。
- [ ] GND スター結線：LiPo− を起点に、Nano TX GND / Buck GND / Pico GND(pin3) を集約。

### 信号
- [ ] Pico **GP0(pin1)** → Nano TX の CRSF/S.Port 信号線。
- [ ] （参照図では TX 線に 680Ω 直列、TXD/RXD を1本に結線。半二重の配線方式は §5 で切り分け）
- [ ] Pico **GP4(pin6)** → USB-シリアル変換 RXD、変換 GND → 共通GND。

### ボタン・LED（新規）
- [ ] **GP2(pin4)** → タクトSW → GND（内部プルアップ使用、外付け抵抗不要）。
- [ ] **GP10/GP11/GP12** → 各 LED アノード、LED カソード → 100Ω → GND（赤/緑/青）。

### 入力プロファイル切替（新規）
- [ ] **GP6(pin9)** → タクトSW → GND（**pin8がGND**で隣接）。
- [ ] **GP13(pin17)** → LED（汎用/中央=ホバリング）→ 100Ω → GND(pin18)。
- [ ] **GP14(pin19)** → LED（LiteRadio/絶対値）→ 100Ω → GND(pin18)。
- ※ pin18 が GP13/GP14 の間にあるので、2つのLEDのカソードをここに集約できる。

---

## 1. ファームウェア書き込み

micro-USB はゲームパッド専有のため、書き込み時のみ手順が特殊。

1. [ ] ゲームパッドと外部5Vを外す。
2. [ ] BOOTSEL を押しながら Pico を PC に micro-USB 接続。`RPI-RP2` がマウントされる。
3. [ ] `./scripts/flash.sh` を実行。
4. [ ] 書き込み後、配線を元に戻す（ゲームパッド接続・外部給電）。

---

## 2. 起動・デバッグUART確認

1. [ ] USB-シリアル変換を PC に接続し、`./scripts/monitor.sh`（921600bps）。
   ⚠️ **手元のFTDI変換器は分周器バグでボーレートが8倍ずれる**ため
   `./scripts/monitor.sh 115200` を指定する（線上は921600bpsのまま）。
2. [ ] 起動バナーと `Mode: SIMPLE ...`、`CRSF UART initialized...`、`signal inversion: ON` が出る。
3. [ ] `?` を送ると、1行目に現在の状態（`# now: SIMPLE / input=...`）＋コマンド一覧が返る。
4. [ ] 1秒ごとのハートビートの先頭がモードに追従する
   （`[SIMPLE   ][CONN] CH1-4: ...` → RECORDに入れば `[REC-idle ]`）。

---

## 3. モード切替（ボタン＋LED）

1. [ ] 起動直後は **青LED(GP12=SIMPLE)** 点灯。
2. [ ] ボタン短押しごとに `# mode -> RECORD/PLAYBACK/SIMPLE` が出て、**赤→緑→青**とLEDが移る。
3. [ ] PLAYBACK に入ると `# playback ready: N samples in flash` が出る（初回は N=0）。
4. [ ] RECORD の赤LEDは**ゆっくり点滅**（=まだ記録していない）、PLAYBACK の緑LEDは**点灯**（=待機）。
   点灯/点滅の意味は §8 参照。

---

## 3.5 入力プロファイル切替（ボタン＋LED2つ）

1. [ ] 起動直後は **GP13のLED点灯**（GENERIC）。バナーに `Input: GENERIC(hover-center)`。
2. [ ] GP6短押しごとに `# input -> ...` が出て、GP13 ⇔ GP14 のLEDが入れ替わる。
3. [ ] GENERIC時のスロットル挙動（**中央=ホバリング推力の位置型**）:
       左スティックを**離した状態（中央）でCH3がホバリング値**（既定20% ≒ 1199us）。
       下端で最小(172)、上端で最大(1811)。**倒した量に比例した位置で止まり、離すと中央値に戻る**。
       → ⚠️ 2026-08-27に廃止した**積算方式**（倒し続けると増え続け、中央で保持）ではない。
       理由はCLAUDE.md「経緯: 積算方式はなぜ失敗したか」参照。
4. [ ] 中央±約9%でCH3がホバリング値から動かない（不感帯が効いている）。
5. [ ] D-pad上下で `# hover trim -> N%` が出て、中央値が±1%ずつ動く。
6. [ ] `t` で現在のホバリング/エクスポ/舵角スケールと各スティック位置の出力[us]が表示される。
7. [ ] ゲームパッドを抜くとCH3が最小(172)・CH7(Arm)が最小に戻る（フェイルセーフ）。

---

## 4. 制御経路の値検証（スナップショット）

SIMPLE モードで、ゲームパッドを操作しながら `d` を送る。

- [ ] `(1) HID raw` に生レポートが出る（全0でない）。VID/PID を控える。
- [ ] `(2) state` のスティック値がゲームパッド操作に追従する。
- [ ] `(3) CRSF ch` が 172〜1811 の範囲で動く。CH3(Throttle) はスロットル最小で172付近。
- [ ] `(5) frame` の末尾 CRC が **OK** 表示。
- [ ] 汎用パーサがズレる場合（値が動かない/軸が違う）は §6 のHID対応を検討。

---

## 5. CRSF反転 — ✅ 決着済み（2026-08-06, Stage D）

**`CRSF_INVERT_SIGNAL=1`（反転ON）のままで機体まで疎通した。** 当初は「ELRS TXモジュールへの
CRSFは非反転では？」と疑っていたが、Nano TX V2 の S.Port は反転入力で正しかった。
GP0のオシロ観測（2026-07-18）でビット幅・極性も確認済み。**この節での切り分けは不要**。

- 配線は GP0 → 680Ω → Nano TX CRSF の1本（半二重）。
- 新しいTXモジュールに替えた時だけ、`src/main.c` の `CRSF_INVERT_SIGNAL` を疑えばよい。
- Nano TX V2 側のシリアルプロトコル設定は CRSF。

---

## 6. HIDパーサの実機対応（必要時）

レポートディスクリプタを `src/hid_parser.c` で解析し、軸の配置を自動で求める
（VID/PID専用パーサが無い機種用）。実機確定済みのデバイス:

| デバイス | VID:PID | 備考 |
|---|---|---|
| Logitech F310 | `046D:C216` | **裏スイッチを D モードに**（Xモードは `046D:C21D` でHIDではない）。軸は `report[0..3]`、ボタンは `((report[4]>>4)\|(report[5]<<4)) & 0x0FFF`、ハットは `report[4]&0x0F` |
| LiteRadio 3 | `0483:572B` | 16bit×8ch。**AETRのチャンネル順**なので LITERADIO プロファイルで素通し |
| DualShock 4 | `054C:09CC` / `054C:05C4` | 専用パーサあり（実機未検証） |

⚠️ **F310 は SDK パッチが必須**。`./scripts/apply_sdk_patch.sh` を当てていないと
列挙・HIDマウントまで成功するのに**レポートが1本も来ない**（RP2040のDATA1バグ）。
症状が出たらまずこれを疑う。詳細は breadboard-bringup.md Stage C。

---

## 7. 機体までの疎通（プロペラを外して）

1. [ ] 機体(Pavo Pico II)の受信機を対象TXにバインド済みにする。
2. [ ] SIMPLE で、Betaflight等のReceiverタブでスティック/スイッチが追従するか確認。
3. [ ] Arm(CH7=Aボタン)は**トグル式**: 1回押すとArm、もう1回でDisarm（プロペラ無し）。
   - ※Betaflight Configurator接続中は MSP/CLI フラグでArm不可（ビープで拒否通知）。USBを抜いて確認する。

---

## 8. 記録 → 再生

記録は**RECORDモードに入った時点では始まらない**。ゲームパッドの**LB**で start/stop する。

1. [ ] RECORD に入る → 赤LEDが**ゆっくり点滅**（待機）、`# RECORD ready: press LB (or 'r') ...`。
2. [ ] **LB** を押す → 赤LEDが**点灯**に変わり `# recording START (buffer cleared)`。
       数十秒操作してもう一度 LB → `# recording STOP (N samples in RAM, ...)`。
       UARTの `r` でも同じ（ベンチでパッドを使わない時用）。
3. [ ] 次のモードへ短押しで抜ける → `# recording stopped, flushed N samples`（N>0）。
       **N ≈ 50 × 記録秒数**（50Hz記録）になっているか確認する。
4. [ ] LBを一度も押さずに RECORD を通過した場合は書き出さない
       → `# nothing recorded, flash log kept (N samples)`。前のログが残ること。
5. [ ] PLAYBACK に入る → 緑LEDが**点灯**（待機）、`# playback ready: N samples`。
6. [ ] **長押し(0.6s)** で再生開始 → 緑LEDが**点滅**に変わり `# playback START`。
       Receiverタブで記録した操作が再現される（点滅＝ボタンを受け付けた合図）。
7. [ ] 末尾で `# playback finished` と緑LEDが点灯に戻る、または長押しで停止。
8. [ ] ログが無い状態で長押し → `# playback not started: no log in flash`（開始しない）。
9. [ ] 電源を入れ直しても PLAYBACK で N が残る（フラッシュ永続）ことを確認。

> 赤LED: ゆっくり点滅=待機 / 点灯=記録中 / 速い点滅=バッファ満杯(120秒)
> 緑LED: 点灯=待機 / 点滅=再生中

---

## 9. フェイルセーフ

1. [ ] SIMPLE で Arm 状態（プロペラ無し）にし、**ゲームパッドを引き抜く**。
2. [ ] 内蔵LEDが点滅に変わり、スロットル最小＋Arm解除（Disarm）になることを Receiverタブ/挙動で確認。
3. [ ] 再接続で復帰することを確認。

---

## 記録テンプレ

| 項目 | 結果 | メモ |
|---|---|---|
| Buck実測電圧 | 未 | Stage F で導入。Stage A-C は PSU 直(5.0V実測/20mA) |
| 反転 ON/OFF どちらで疎通 | **反転ON** (2026-08-06) | §5 / Stage D で決着。GP0波形もオシロ確認済み(2026-07-18) |
| ゲームパッド VID/PID | **046D:C216** (F310 / Dモード) | Xモードは 046D:C21D で**HIDではない**ので必ず裏スイッチを **D** に |
| HIDパーサ調整要否 | **要（ボタンのみ）** | §6 / 軸 `report[0..3]` は現行のままで正解。ボタンは `((report[4]>>4)|(report[5]<<4)) & 0x0FFF`、ハットは `report[4]&0x0F`。配置は breadboard-bringup.md Stage C 参照 |
| 記録→再生 サンプル数 | 137 (2026-07-16, ベンチ) | パッド無しでのStage B確認時。50Hzで2.74秒分、レート正常 |
| フェイルセーフ動作 | **合格** (2026-08-06) | Stage D でArm中にパッドを引き抜き→即モーター停止、再接続で復帰 |
| 記録start/stop (LB) | **合格** (2026-10-20) | 待機=ゆっくり点滅 → LBで点灯 → 再度LBで点滅に戻る |
| 再生中の緑LED点滅 | **合格** (2026-10-20) | 待機=点灯 → 長押しで点滅 → 末尾で点灯に戻る |
| 記録サンプル数 N の妥当性 | 未 | N ÷ 50 = 記録秒数 になるか。2026-10-20は数えていない |
| 再生値と記録値の一致 | 未 | シリアルログを残して突き合わせる |

> ✅ **解決済み (2026-07-18)**: 「F310(Dモード)が列挙・HIDマウントまで成功するのにレポートを
> 1本も返さない」問題は、**F310が最初のInterrupt IN転送をDATA1 PIDで始める**ことと
> **RP2040のデータシーケンスエラーから回復できないチップバグ**(TinyUSB issue #2776)の組み合わせだった。
> 該当EPの初期PIDをDATA1にするパッチで回避している（`./scripts/apply_sdk_patch.sh`）。
> **SDKを入れ直すと失われる**ので、同じ症状が出たらまずパッチの適用を確認すること。
> 詳細は [breadboard-bringup.md](breadboard-bringup.md) Stage C 実施記録。
