akiihito/expresslrs_realtime_recorder/hardware/recorder.pdf

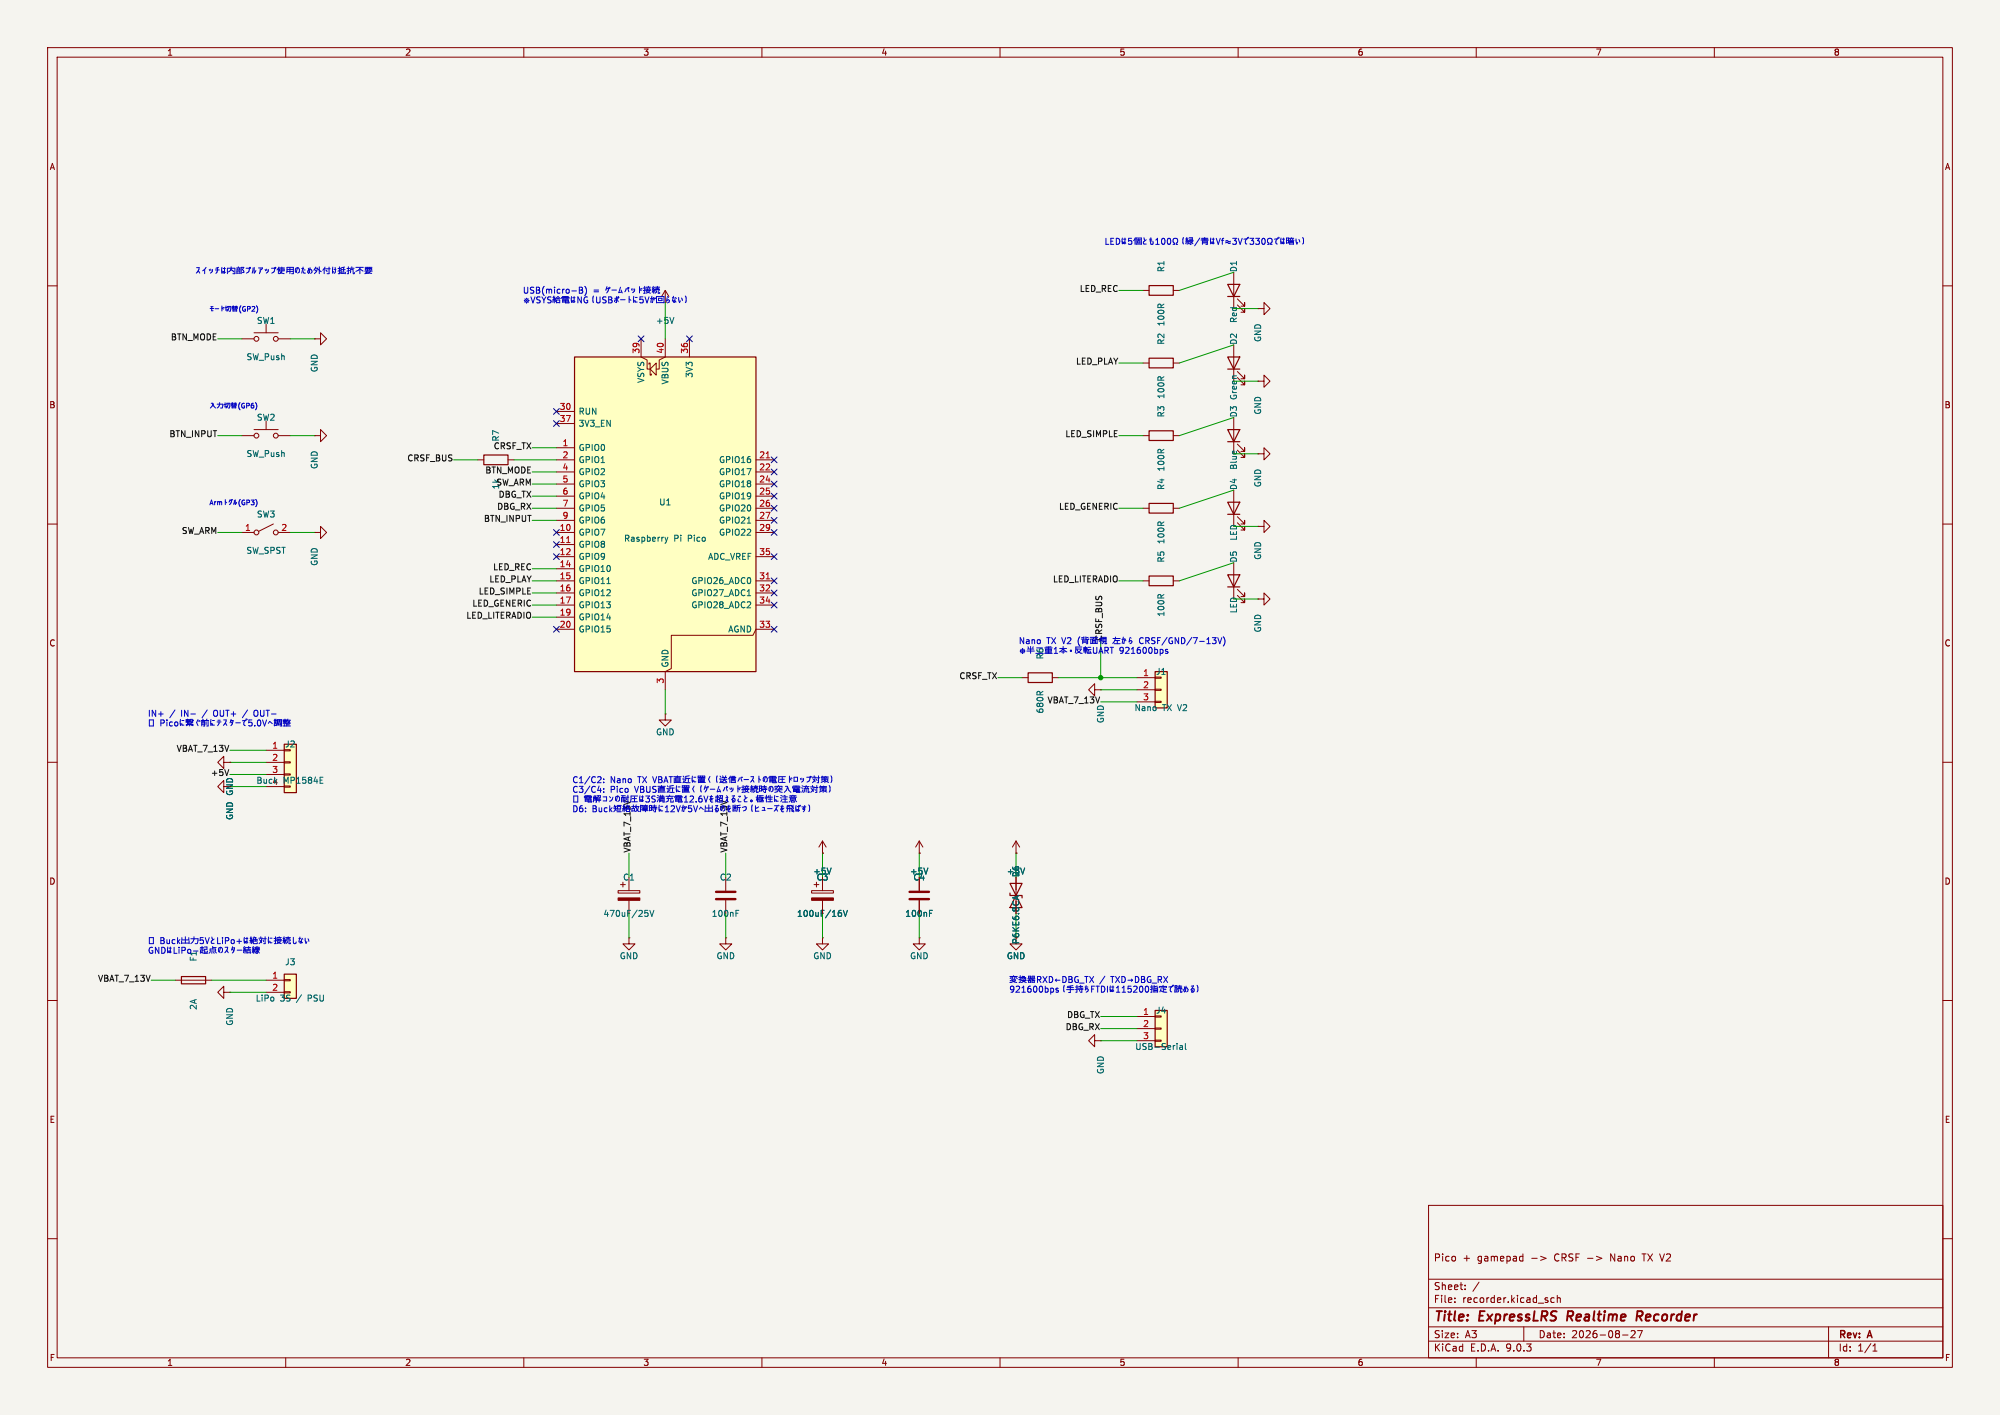
[picture p2: page 1]

þÿ ;VSYS}f–û0oNGÿUSB0Ý0ü0È0k5V0LVÞ0‰0j0Dÿ D6: þÿBuckwí}aeE–œfB0k12V0L5V0xQú0‹0n0’e-0dÿ0Ò0å0ü0º0’˜Û0p0Yÿ

3 3V3 36 GPIO16 21 GPIO17 22 GPIO18 24 GPIO19 25 GPIO20 26 GPIO21 27 GPIO22 29 ADC_VREF 35 GPIO26_ADC0 31 GPIO27_ADC1 32 GPIO28_ADC2 34 AGND 33 U1 Raspberry Pi Pico D6 P6KE6.8CA GND

þÿ ;SJNŒ‘Í1g,0ûSÍŽâUART 921600bps Nano TX V2 þÿ(€Ì—b‰– þÿ]æ0K0‰CRSF/GND/7-13V)

IN+ / IN- / OUT+ / OUT-
þÿ& þ þÿPico0k~K0PRM0k0Æ0¹0¿0ü0g5.0V0xŠ¿et
