akiihito/expresslrs_realtime_recorder/hardware/pcb-fab.pdf

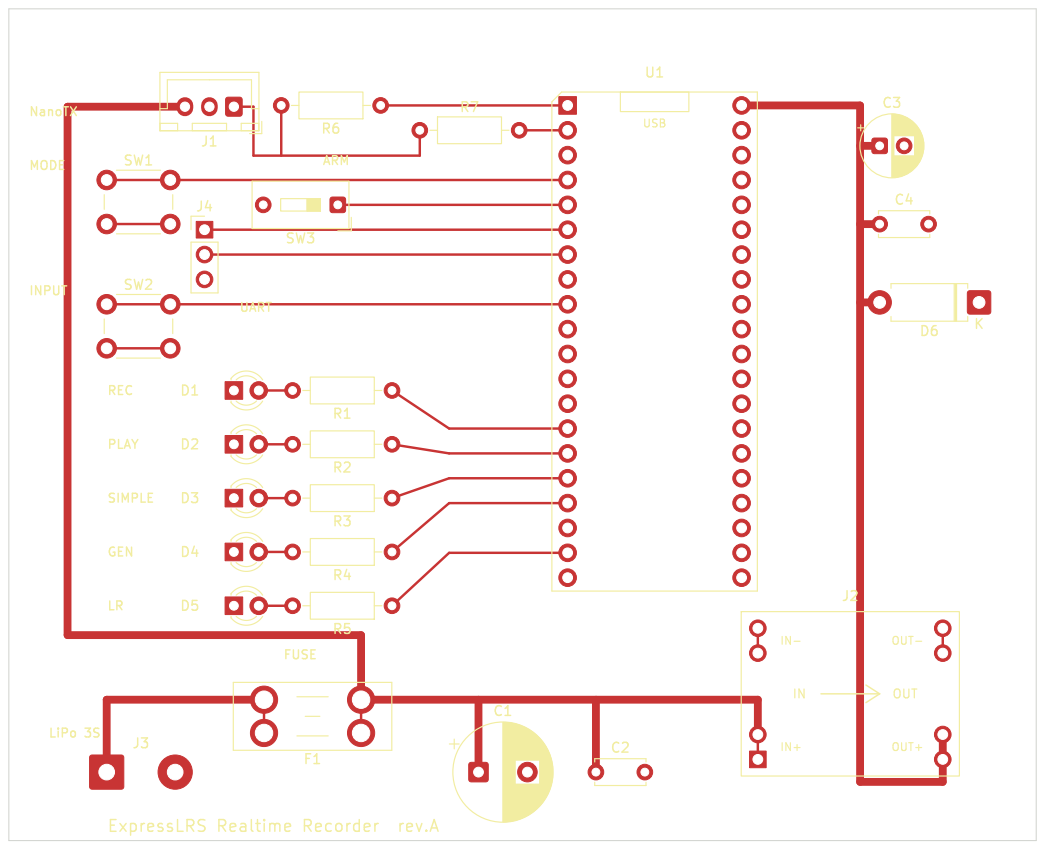
[picture p3: page 1]
