akiihito/expresslrs_realtime_recorder/hardware/recorder.kicad_pcb

## KiCad design hardware/recorder.kicad_pcb (2026-09-30)

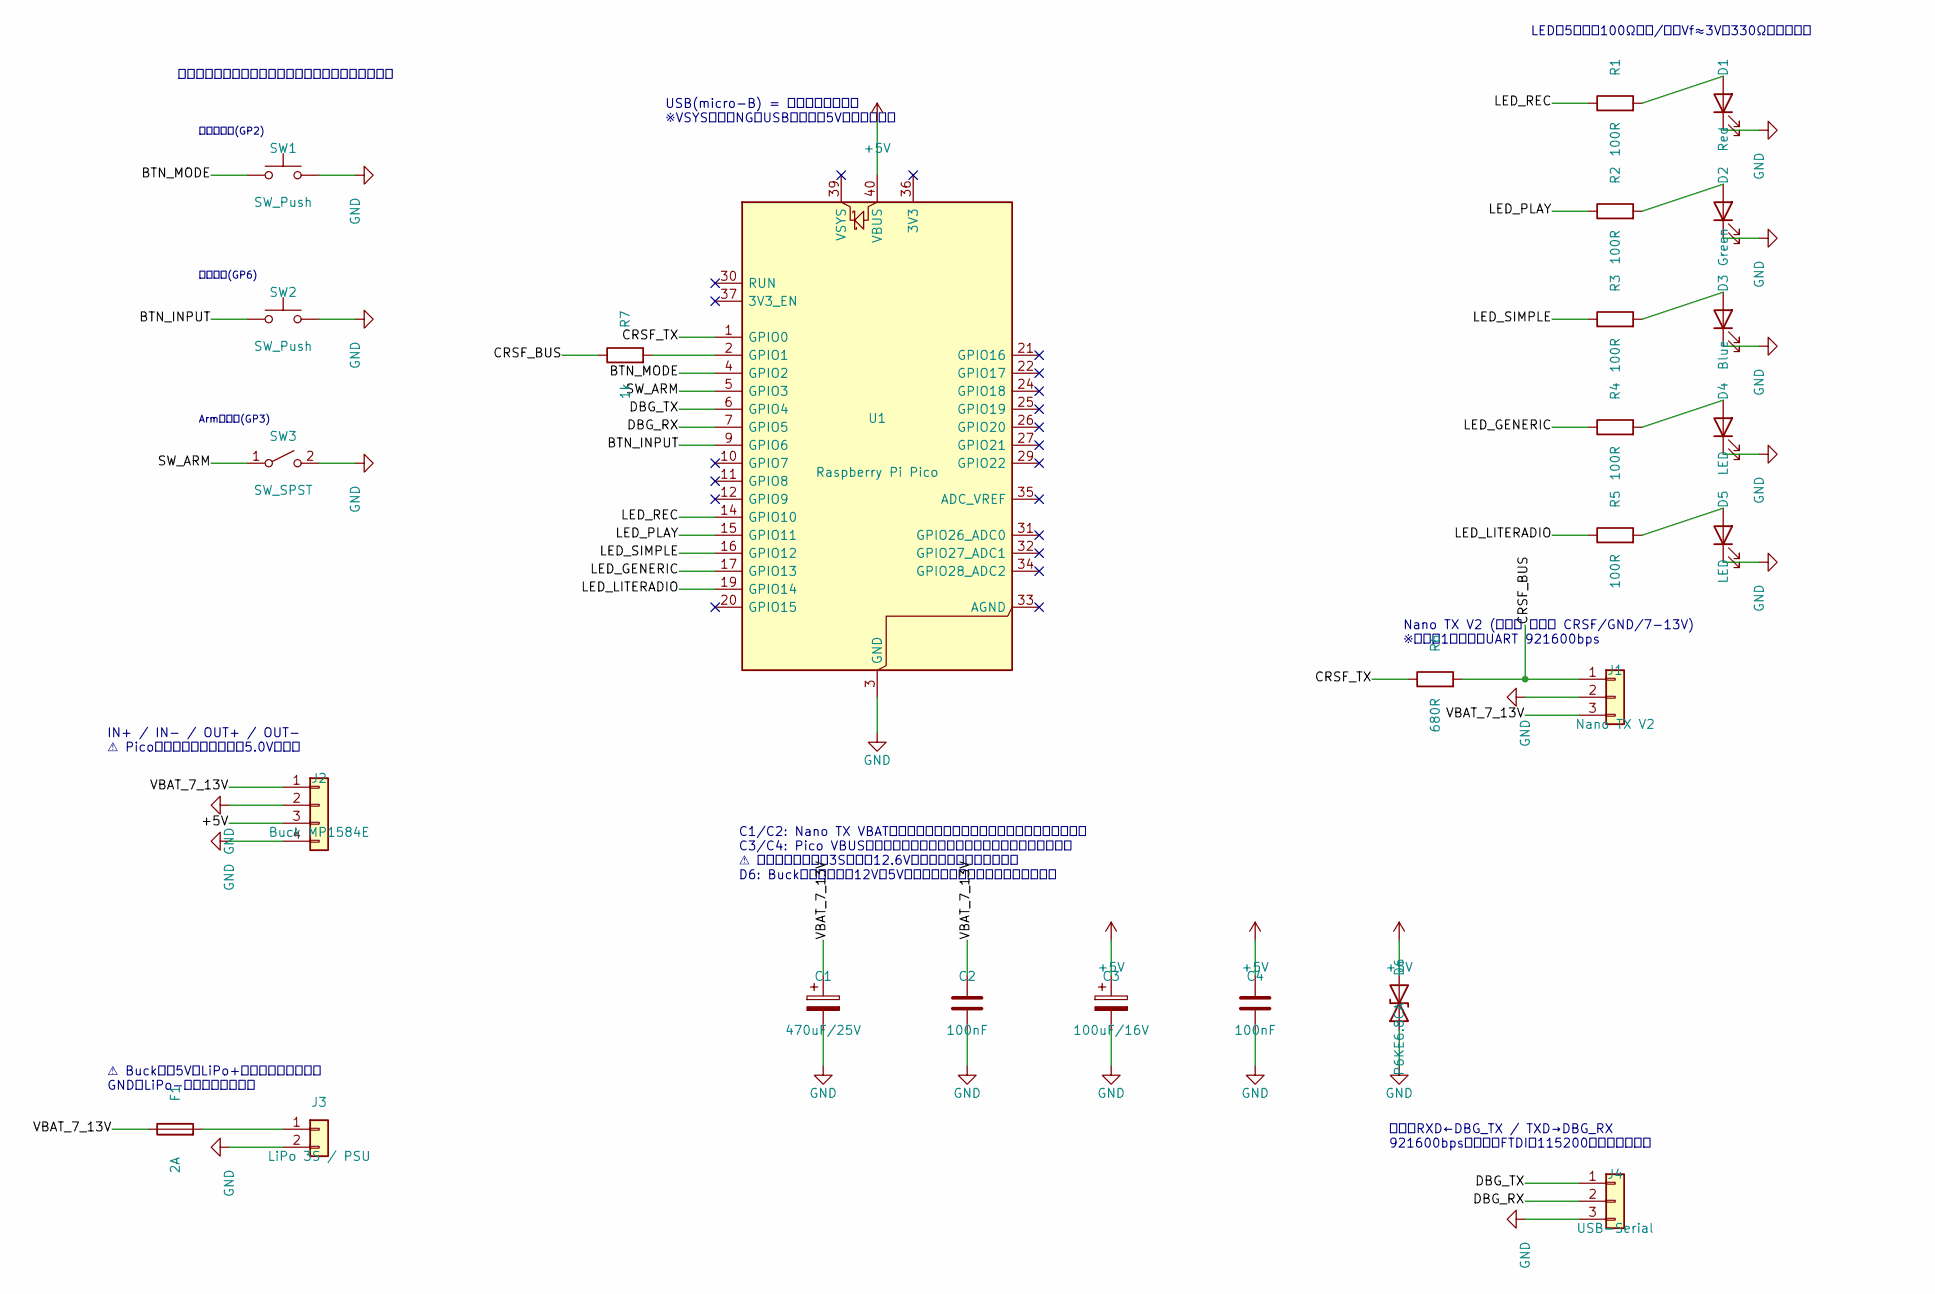
[picture p4: schematic recorder.kicad_sch, ExpressLRS Realtime Recorder]

Parts:
C1: 470uF/25V; CP_Radial_D10.0mm_P5.00mm
C2, C4: 100nF; C_Disc_D5.0mm_W2.5mm_P5.00mm
C3: 100uF/16V; CP_Radial_D6.3mm_P2.50mm
D1: Red; LED_D3.0mm
D2: Green; LED_D3.0mm
D3: Blue; LED_D3.0mm
D4, D5: LED; LED_D3.0mm
D6: P6KE6.8CA; D_DO-15_P10.16mm_Horizontal
F1: 2A; Fuseholder_Blade_Mini_Keystone_3568
J1: Nano TX V2; JST_XH_B3B-XH-A_1x03_P2.50mm_Vertical
J2: Buck MP1584E; MP1584EN_Module
J3: LiPo 3S / PSU; SolderWire-0.75sqmm_1x02_P7mm_D1.25mm_OD3.5mm
J4: USB-Serial; PinHeader_1x03_P2.54mm_Vertical
R1, R2, R3, R4, R5: 100R; R_Axial_DIN0207_L6.3mm_D2.5mm_P10.16mm_Horizontal
R6: 680R; R_Axial_DIN0207_L6.3mm_D2.5mm_P10.16mm_Horizontal
R7: 1k; R_Axial_DIN0207_L6.3mm_D2.5mm_P10.16mm_Horizontal
SW1, SW2: SW_Push; SW_PUSH_6mm
SW3: SW_SPST; SW_DIP_SPSTx01_Slide_9.78x4.72mm_W7.62mm_P2.54mm
U1: Raspberry Pi Pico; RPi_Pico_Headers

Connections:
+5V: C3.1, C4.1, D6.2 (A2), J2.3, U1.40 (VBUS)
/BTN_INPUT: SW2.1, U1.9 (GPIO6)
/BTN_MODE: SW1.1, U1.4 (GPIO2)
/CRSF_BUS: J1.1, R6.2, R7.1
/CRSF_TX: R6.1, U1.1 (GPIO0)
/DBG_RX: J4.2, U1.7 (GPIO5)
/DBG_TX: J4.1, U1.6 (GPIO4)
/LED_GENERIC: R4.1, U1.17 (GPIO13)
/LED_LITERADIO: R5.1, U1.19 (GPIO14)
/LED_PLAY: R2.1, U1.15 (GPIO11)
/LED_REC: R1.1, U1.14 (GPIO10)
/LED_SIMPLE: R3.1, U1.16 (GPIO12)
/SW_ARM: SW3.1 (A), U1.5 (GPIO3)
/VBAT_7_13V: C1.1, C2.1, F1.1, J1.3, J2.1
GND: C1.2, C2.2, C3.2, C4.2, D1.1 (K), D2.1 (K), D3.1 (K), D4.1 (K), D5.1 (K), D6.1 (A1), J1.2, J2.2, J2.4, J3.2, J4.3, SW1.2, SW2.2, SW3.2 (B), U1.3 (GND), U1.8 (GND), U1.13 (GND), U1.18 (GND), U1.23 (GND), U1.28 (GND), U1.38 (GND)
unnamed: D1.2 (A), R1.2
unnamed: D2.2 (A), R2.2
unnamed: D3.2 (A), R3.2
unnamed: D4.2 (A), R4.2
unnamed: D5.2 (A), R5.2
unnamed: F1.2, J3.1
unnamed: R7.2, U1.2 (GPIO1)

Notes on the sheet:
USB(micro-B) = ゲームパッド接続
※VSYS給電はNG（USBポートに5Vが回らない）
LEDは5個とも100Ω（緑/青はVf≈3Vで330Ωでは暗い）
モード切替(GP2)
入力切替(GP6)
Armトグル(GP3)
スイッチは内部プルアップ使用のため外付け抵抗不要
Nano TX V2 (背面視 左から CRSF/GND/7-13V)
※半二重1本・反転UART 921600bps
IN+ / IN- / OUT+ / OUT-
⚠️ Picoに繋ぐ前にテスターで5.0Vへ調整
⚠️ Buck出力5VとLiPo+は絶対に接続しない
GNDはLiPo−起点のスター結線
C1/C2: Nano TX VBAT直近に置く（送信バーストの電圧ドロップ対策）
C3/C4: Pico VBUS直近に置く（ゲームパッド接続時の突入電流対策）
⚠️ 電解コンの耐圧は3S満充電12.6Vを超えること。極性に注意
D6: Buck短絡故障時に12Vが5Vへ出るのを断つ（ヒューズを飛ばす）
変換器RXD←DBG_TX / TXD→DBG_RX
921600bps（手持ちFTDIは115200指定で読める）

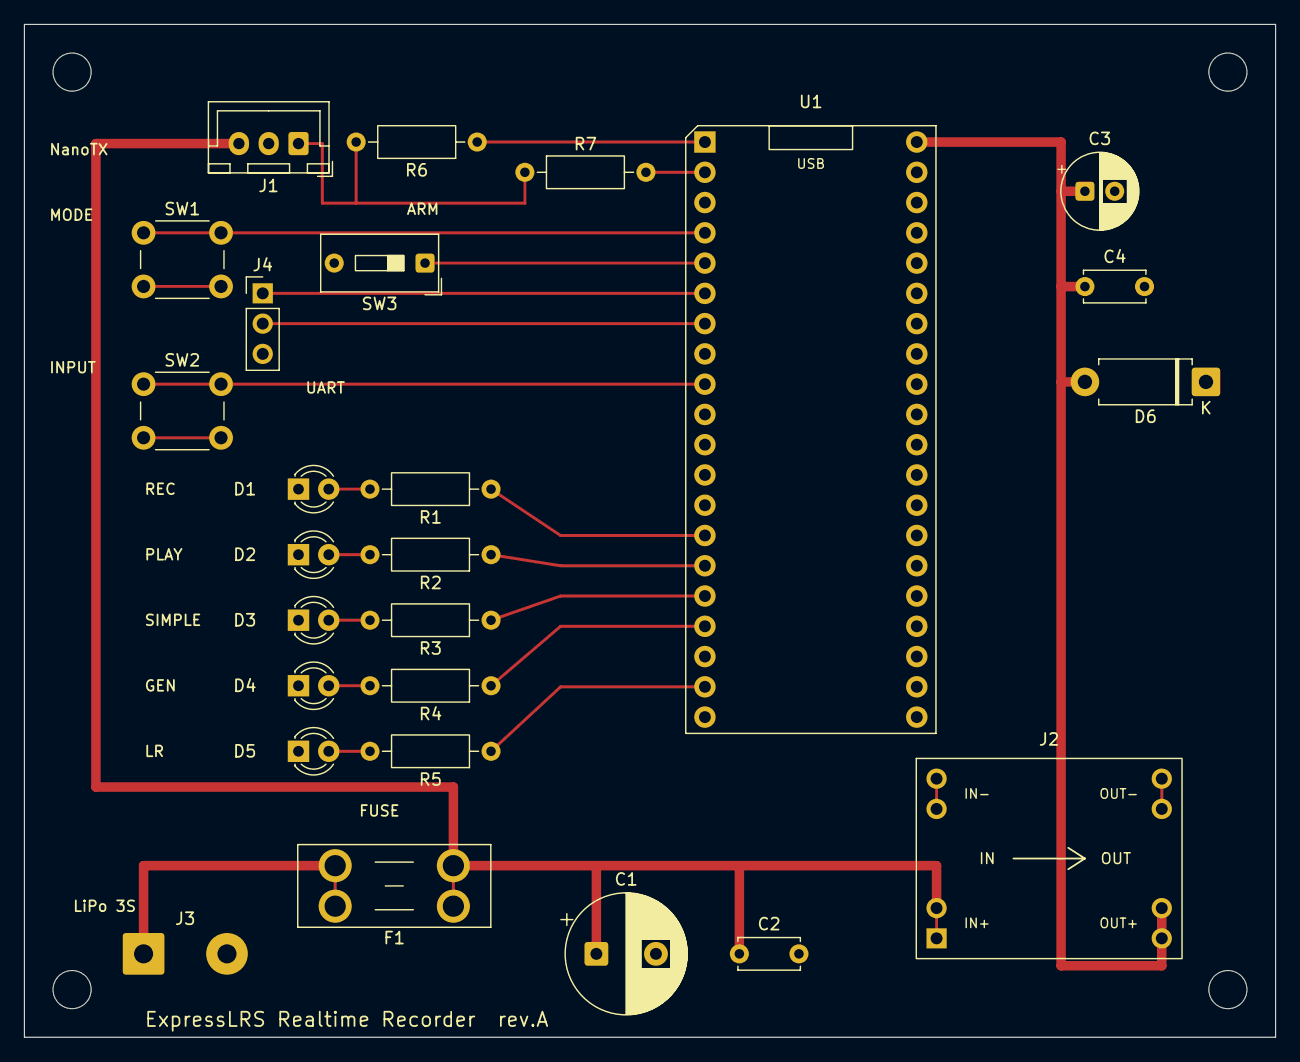
[picture p5: board recorder.kicad_pcb from above]

Board: 2 copper layers, 105.0 x 85.0 mm, 30 parts (0 on the bottom side), 22 nets.

Other parts of the board:
H1, H2, H3, H4: MountingHole_3.2mm_M3
