akiihito/expresslrs_realtime_recorder/src/main.c

#include <stdio.h>
#include <string.h>
#include "crsf.h"
#include "usb_gamepad.h"
#include "recorder.h"

#ifdef PICO_BOARD
#include "pico/stdlib.h"
#include "hardware/uart.h"
#include "hardware/gpio.h"
#include "tusb.h"

// ========================================
// ピン設定
// ========================================

// CRSF出力用UART（Nano TX Moduleへ）
#define CRSF_UART       uart0
#define CRSF_UART_TX    0   // GP0
#define CRSF_UART_RX    1   // GP1 (半二重テレメトリ受信に使用)
// ELRS V3.x の BetaFPV Nano TX Module V2 は 921600bps
// （旧来のレシーバ直結用 420000 ではなくモジュール用の高速ボーレート）
#define CRSF_BAUD_RATE  921600

// Nano TX V2 の S.Port は反転UART。Pico側でTX/RXを反転する。
// （senderでは Pi の dtoverlay で反転していたのと同等の処理）
#define CRSF_INVERT_SIGNAL  1

// デバッグ用UART
// stdio(printf/getchar) は CMake の PICO_DEFAULT_UART=1 設定により
// uart1 = GP4(TX)/GP5(RX) @921600bps にルーティングされる。
#define DEBUG_UART      uart1
#define DEBUG_UART_TX   4   // GP4
#define DEBUG_UART_RX   5   // GP5
#define DEBUG_BAUD_RATE 921600

// 連続ストリーム(C)の間引き: 500Hz / 20 = 25Hz で出力
#define DEBUG_STREAM_DECIMATION 20

// LED（内蔵: 接続/再生ステータス表示用）
#define LED_PIN         PICO_DEFAULT_LED_PIN

// ========================================
// モード切替 (ボタン + 外付けLED)
// ========================================
// 参照図(63bit氏 R63b)の空きGPIO配置に合わせる。
// ボタン: GP2 にタクトSW（内部プルアップ, 押下=Low）。押すたびにモード循環。
#define MODE_BTN_PIN     2
// モード表示LED（各 330Ω 直列で GND へ）
#define LED_RECORD_PIN   10  // 赤: 記録
#define LED_PLAYBACK_PIN 11  // 緑: 再生
#define LED_SIMPLE_PIN   12  // 青: 単純
// ボタンのデバウンス時間
#define MODE_BTN_DEBOUNCE_MS 30
// 長押し判定のしきい値（これ以上保持で「長押し」= 再生start/stop）
#define MODE_BTN_LONG_MS     600

// ========================================
// 入力プロファイル切替 (ボタン + LED2つ)
// ========================================
// スティックが自動中央復帰する汎用ゲームパッドと、位置が保持される
// LiteRadio3のジンバルでは、スロットルの解釈を変える必要がある。
// GP6のボタンで切り替え、GP13/GP14のLEDで現在のプロファイルを表示する。
// ピン選定: GP6はpin9でGND(pin8)が隣。GP13(pin17)/GP14(pin19)はGND(pin18)を
// 挟んで両隣なのでLED2つのカソードを1点にまとめられる。
// （GP3はArmスイッチ用に予約。GP15=pin20は本個体にヘッダ未実装のため使わない）
#define INPUT_BTN_PIN            6
#define LED_INPUT_GENERIC_PIN    13  // 汎用ゲームパッド（スロットル積算）
#define LED_INPUT_LITERADIO_PIN  14  // LiteRadio3（スロットル絶対値）
#define INPUT_BTN_DEBOUNCE_MS    30

// スロットルのパラメータ（INPUT_GENERIC時のみ有効）
//
// 自動中央復帰スティックでも、**中央をホバリング推力に割り当てる**ことで
// プロポと同じ「位置＝推力」にできる。
//   下端=最小 / 中央=ホバリング / 上端=最大
//
// ⚠️ 初版は積算方式（倒し量=増減の速さ）だったが、実飛行(2026-08-27)で
// 操作不能だった。スロットル→高さは元々2重積分（推力→速度→高さ）であり、
// 積算を挟むと**3重積分**になる。人間が閉ループで3重積分を制御するのは
// ほぼ不可能で、カーブを緩めても構造は変わらないため方式ごと差し替えた。
//
// ホバリング推力[%]。機体重量やバッテリー電圧で変わるためUARTで調整可能。
// ⚠️ この方式では「手を離す＝この推力が出る」ため、実際のホバリング値より
// 高いと手を離した瞬間に上昇する（とっさに手を離す動作が安全側に働かない）。
// 低い分は「浮かない・ゆっくり降りる」だけなので、**必ず低めから始めて上げる**。
// 既定20%は安全側の初期値（実飛行 2026-08-27 で30%はまだ高く、中央に戻る前に
// 浮き始めた）。実機で釣り合う値を見つけたらここに焼き直すこと。
#define THROTTLE_HOVER_DEFAULT_PCT   20
// 位置カーブのエクスポ量[%]。0=線形、100=3乗。
// 大きいほど中央付近が緩やかになり、ホバリング付近の微調整がしやすい。
#define THROTTLE_EXPO_DEFAULT_PCT    75

// 上側（上昇方向）の可動幅[%]。中央(ホバリング)から上端までが、CRSF全幅の何%か。
//
// ⚠️ これが無いと上下の可動幅が極端に非対称になる。ホバリングは中央より下
// （既定20%）にあるので、上端=CRSF最大のままだと **下側20ポイントに対し上側80
// ポイント＝上が4倍敏感**。さらに推力はスロットルのほぼ2乗で効くため、低い
// ホバリング点からの増加は相対的に激しくなる。実測相当の試算（推力∝スロットル²、
// ホバリング20%=1g）では、上に半分倒すだけで **正味+1.95g**（重力の3倍の推力）
// に達していた。実飛行 2026-10-20 で「少し倒すと加速がすごく制御できない」
// となったのはこれが原因。
//
// エクスポはカーブの形を変えるだけで**上端の値は変えられない**ので、舵角に
// STICK_SCALE を入れたのと同じ理屈で、上側の幅そのものを絞る。
// 既定15%（上端=ホバリング+15ポイント）での試算:
//   上25%→+0.06g / 上50%→+0.28g / 上75%→+0.81g / 上100%→+2.04g
// 下側は -0.09g / -0.33g / -1.00g(自由落下) なので、中間の倒し量で上下の
// 加速がほぼ対称になる。位置型スロットルとしてはこれが狙い。
//
// 代償: フルスロットルに届かない（上端=35%）。室内のホバリング用途では問題
// ないが、パンチアウトはできない。飛行中にUARTの `5`/`6` で変えられる。
#define THROTTLE_UP_RANGE_DEFAULT_PCT 15

// ロール/ピッチ/ヨーのエクスポ量[%]（GENERIC時のみ）。
// ゲームパッドのスティックは実機プロポのジンバルよりストロークが遥かに短く、
// 同じ親指の動きでも操作量の割合が何倍にもなるため極端に敏感になる
// （実飛行 2026-08-27: 少し倒すだけで機体が回ってしまった）。
// これは入力デバイス固有の特性なので、Betaflightのrates（機体側で共通）ではなく
// プロファイルごとに補正する。LiteRadioはジンバルが長いので適用しない。
// 実飛行 2026-08-27 で詰めた途中経過。既定50%ではまだ急だったため85%まで上げた。
#define STICK_EXPO_DEFAULT_PCT       85

// ロール/ピッチ/ヨーの舵角スケール[%]（GENERIC時のみ）。
// エクスポはカーブの形を変えるだけで**フル時の舵角は変えられない**ため、
// 「全体的に効きすぎる」場合はこちらで出力そのものを絞る。
// 100=フル舵角、60=フルに倒しても6割の舵角。Betaflightのratesを下げるのと
// 同等だが、入力デバイスごとに設定できる点と、飛行中にUARTで詰められる点が違う。
// 実飛行 2026-08-27 で詰めた途中経過。既定60%ではまだ効きすぎだったため35%まで絞った。
#define STICK_SCALE_DEFAULT_PCT      35
// 中央付近の不感帯（軸のフルスケール32767に対する値）。
// 手を離したとき確実にホバリング値へ戻るための平坦域。
#define THROTTLE_DEADZONE            3000

// 入力プロファイル（ボタン押下で GENERIC ⇔ LITERADIO をトグル）
typedef enum {
    INPUT_GENERIC = 0,   // 汎用ゲームパッド: 左スティック上下=スロットルの増減率
    INPUT_LITERADIO,     // LiteRadio3: 左スティック位置=スロットル絶対値
    INPUT_PROFILE_COUNT
} input_profile_t;

// 起動時は手持ちの汎用ゲームパッド。LiteRadioは接続時に手動で切り替える。
static input_profile_t current_input = INPUT_GENERIC;

// 入力プロファイル切替ボタンの状態（デバウンス用）
static bool     ibtn_pressed_state = false;
static uint32_t ibtn_last_change_ms = 0;

// スロットル特性は実飛行で詰めたいので、UARTコマンドで変更できる変数にしてある
// （書込みにはゲームパッドを抜いてBOOTSELが必要で試行錯誤しづらいため）。
// 電源を切ると既定値に戻る。詰まった値は上の DEFAULT に焼き直すこと。
static uint32_t throttle_hover_pct = THROTTLE_HOVER_DEFAULT_PCT;
static uint32_t throttle_expo_pct  = THROTTLE_EXPO_DEFAULT_PCT;
static uint32_t throttle_up_range_pct = THROTTLE_UP_RANGE_DEFAULT_PCT;
static uint32_t stick_expo_pct     = STICK_EXPO_DEFAULT_PCT;
static uint32_t stick_scale_pct    = STICK_SCALE_DEFAULT_PCT;

// 実体はLED制御と並べて後述。UARTコマンド 'i' からも呼ぶため先に宣言する。
static void input_profile_toggle(void);
static const char* input_name(input_profile_t p);
static const char* status_tag(void);

// 動作モード（押下で SIMPLE→RECORD→PLAYBACK→SIMPLE… と循環）
typedef enum {
    MODE_SIMPLE = 0,   // 単純: gamepad → CRSF（現行のパススルー）
    MODE_RECORD,       // 記録: gamepad → CRSF ＋ ログ保存（Phase2で実装）
    MODE_PLAYBACK,     // 再生: フラッシュ → CRSF（Phase3で実装）
    MODE_COUNT
} op_mode_t;

// 起動時は最も安全な単純パススルー。誤って再生で機体を駆動しないため。
static op_mode_t current_mode = MODE_SIMPLE;

// ボタン状態（デバウンス＋短押し/長押し判別用）
static bool     btn_pressed_state = false;   // 確定済みの押下状態
static uint32_t btn_last_change_ms = 0;
static uint32_t btn_press_start_ms = 0;      // 押下開始時刻
static bool     btn_long_fired = false;      // 今回の押下で長押しアクション済みか

// 記録状態（RECORDモード中、ゲームパッドのLB or 'r' コマンドで開始/停止）。
// RECORDモードに入っただけでは記録しない。モード切替の手間取りが記録に
// 混ざって切れ目が分からなくなるため、LBを押した時点から記録する。
static bool     recording_on = false;
// この滞在中に一度でも記録したか。LBを押さずにRECORDを通過しただけのとき
// フラッシュを空ログで上書きしないための印。
static bool     rec_dirty = false;
// 記録トリガー(LB)のエッジ検出用。Arm/トリムが使う prev_buttons とは別に持つ:
// あちらは map_gamepad_to_channels でしか更新されず、LITERADIOプロファイル
// （map_radio_to_channels）では止まってしまうため。
static uint16_t rec_prev_buttons = 0;

// 再生状態（PLAYBACKモードで長押し or 'p' コマンドにより開始/停止）
static bool     playback_running = false;
static uint32_t pb_sample_idx = 0;   // 次に送出するフラッシュサンプル番号
static uint16_t pb_frame_ctr = 0;    // 50Hz送出のための500Hzフレームカウンタ

// 再生の開始/停止をトグル（PLAYBACKモードでのみ有効）。
// long-press と 'p' コマンドの両方から使う共通処理。
static void playback_toggle(void) {
    if (current_mode != MODE_PLAYBACK) {
        printf("# playback toggle ignored (not in PLAYBACK mode)\n");
        return;
    }
    uint32_t n = recorder_flash_sample_count();
    if (!playback_running && n == 0) {
        // 空のまま開始すると緑LEDが点滅して「再生中」に見えるのに何も起きない。
        // 受け付けられなかったことを出して、待機のまま留まる。
        printf("# playback not started: no log in flash\n");
        return;
    }
    playback_running = !playback_running;
    if (playback_running) { pb_sample_idx = 0; pb_frame_ctr = 0; }
    printf("# playback %s (%u samples)\n",
           playback_running ? "START" : "STOP", (unsigned)n);
}

// 記録の開始/停止をトグル（RECORDモードでのみ有効）。
// LB押下エッジと UART 'r' の両方から使う共通処理。
//   開始: バッファをクリアして録り直す（=「最後に開始した所からの記録」）。
//         一時停止/再開で区間を継ぎ足すと再生時に不連続なジャンプが起きる。
//   停止: RAMへの追記を止めるだけ。
// ⚠️ 停止でフラッシュに書いてはいけない。RP2040はフラッシュ書込み中にXIPが
//    止まり500Hz送信が破綻するため、飛行中に書くと墜落する。書出しは従来どおり
//    RECORDモードを抜けた時（=着地後）に行う。
static void recording_toggle(void) {
    if (current_mode != MODE_RECORD) {
        printf("# record toggle ignored (not in RECORD mode)\n");
        return;
    }
    if (!recording_on) {
        recorder_start();          // バッファをクリアして記録開始
        recording_on = true;
        rec_dirty = true;
        printf("# recording START (buffer cleared)\n");
    } else {
        recording_on = false;
        printf("# recording STOP (%u samples in RAM, flushed on leaving RECORD)\n",
               (unsigned)recorder_ram_sample_count());
    }
}

// 記録トリガー(LB)のポーリング。押下エッジで記録のON/OFFを切り替える。
// ショルダーボタンなら人差し指で押せるので、飛行中に親指をスティックから
// 離さずに済む。Armが右親指のAボタンなので、手を分けて取り違えを防ぐため
// 右のRBではなく左のLBを使う。
// LiteRadio 3 では「ボタン5相当のスイッチ」が同じビット(bit4)で届く。
static void poll_record_trigger(const gamepad_state_t *gamepad) {
    if (!gamepad->connected) {
        rec_prev_buttons = 0;  // 切断中はエッジを持ち越さない（再接続で誤発火しないように）
        return;
    }
    uint16_t btn = gamepad->buttons;
    // RECORD以外では黙って無視する（LBはCH11にも出るので press ごとに
    // ログを吐くと飛行中のUARTが埋まる）。エッジ追跡は全モードで続ける。
    if (current_mode == MODE_RECORD &&
        (btn & GAMEPAD_BTN_LB) && !(rec_prev_buttons & GAMEPAD_BTN_LB)) {
        recording_toggle();
    }
    rec_prev_buttons = btn;
}

// ========================================
// CRSF送信設定
// ========================================

// CRSF送信間隔（ミリ秒）
// ExpressLRS 500Hz = 2ms間隔
#define CRSF_SEND_INTERVAL_MS  2  // 500Hz（senderと同じ。ELRS V3.x標準）

// ========================================
// グローバル変数
// ========================================

// CRSFチャンネル値
static uint16_t crsf_channels[CRSF_NUM_CHANNELS];

// 最後のCRSF送信時刻
static uint32_t last_crsf_send_time = 0;

// ログカウンタ
static uint32_t log_counter = 0;

// ========================================
// デバッグ/値確認の状態
// ========================================

// 'd' コマンドで次フレームの全段スナップショットを要求
static bool dbg_snapshot_request = false;
// 's' コマンドで連続ストリーム(C)をON/OFF（デフォルトOFF）
static bool dbg_stream_enabled = false;
// ストリーム間引きカウンタ
static uint16_t dbg_stream_counter = 0;
// 直近のドレインで読み捨てたテレメトリ（スナップショット(6)用）
static uint8_t dbg_drain_buf[32];
static uint16_t dbg_drain_len = 0;

// ========================================
// チャンネルマッピング
// ========================================

// 軸の上下反転。-INT16_MIN は int16 に収まらず -32768 のまま化けるため飽和させる
static inline int16_t axis_invert(int16_t v) {
    return (v == INT16_MIN) ? INT16_MAX : (int16_t)-v;
}

// Arm(CH7)のトグルラッチ。ゲームパッドのAは押しボタン（モーメンタリ）で
// 押し続けられないため、押下エッジごとにArm/Disarmを切り替える。
static bool arm_latched = false;
static uint16_t prev_buttons = 0;

// エクスポカーブ。mag(0〜32767) に対し、線形と3乗を expo_pct で混ぜる。
// 中央付近だけを緩やかにし、フル付近の効きは保つ。
static int32_t apply_expo(int32_t mag, uint32_t expo_pct) {
    if (expo_pct == 0) return mag;
    if (mag > 32767) mag = 32767;
    int64_t cube = (int64_t)mag * mag * mag / ((int64_t)32767 * 32767);
    return (int32_t)(((int64_t)(100 - expo_pct) * mag
                      + (int64_t)expo_pct * cube) / 100);
}

// ロール/ピッチ/ヨー用。符号を保ったままエクスポを掛け、舵角を絞る。
static int16_t stick_shape(int16_t v) {
    int32_t mag = (v < 0) ? -(int32_t)v : (int32_t)v;
    mag = apply_expo(mag, stick_expo_pct);
    mag = mag * (int32_t)stick_scale_pct / 100;
    return (int16_t)((v < 0) ? -mag : mag);
}

// ホバリング推力に対応するCRSF値
static uint16_t throttle_hover_crsf(void) {
    return (uint16_t)(CRSF_CHANNEL_MIN
                    + (int32_t)(CRSF_CHANNEL_MAX - CRSF_CHANNEL_MIN)
                      * (int32_t)throttle_hover_pct / 100);
}

// 上側の可動幅の上端に対応するCRSF値（中央=ホバリングから上へ何ポイントか）
static uint16_t throttle_top_crsf(void) {
    int32_t top = (int32_t)throttle_hover_crsf()
                + (int32_t)(CRSF_CHANNEL_MAX - CRSF_CHANNEL_MIN)
                  * (int32_t)throttle_up_range_pct / 100;
    if (top > CRSF_CHANNEL_MAX) top = CRSF_CHANNEL_MAX;
    return (uint16_t)top;
}

// 汎用ゲームパッド用のスロットル。中央をホバリング推力に割り当てた位置型。
//   下端 → CRSF最小 / 中央 → ホバリング / 上端 → ホバリング+上側の可動幅
// 倒し量が「上昇・下降の速さ」になり、手を離せばホバリング推力に戻る。
// 積分器を挟まないので、プロポと同じ操作感になる。
static uint16_t throttle_from_position(int16_t stick_up) {
    uint16_t hover = throttle_hover_crsf();

    // 不感帯を差し引き、残りを 0〜32767 に引き伸ばす（符号は後で戻す）
    int32_t mag = stick_up < 0 ? -(int32_t)stick_up : (int32_t)stick_up;
    if (mag <= THROTTLE_DEADZONE) {
        return hover;  // 中央付近は確実にホバリング値
    }
    mag = (mag - THROTTLE_DEADZONE) * 32767 / (32767 - THROTTLE_DEADZONE);

    // エクスポ。中央付近を緩やかにしてホバリング付近の微調整をしやすくする。
    mag = apply_expo(mag, throttle_expo_pct);

    // 上下で可動幅が違う（ホバリングは中央より下にあるのが普通）ため、
    // それぞれの側の幅に対して比例させる。上側は THROTTLE_UP_RANGE_PCT で
    // 絞る（絞らないと上が4倍敏感になる。定数のコメント参照）。
    int32_t out;
    if (stick_up >= 0) {
        out = hover + (int32_t)(throttle_top_crsf() - hover) * mag / 32767;
    } else {
        out = hover - (int32_t)(hover - CRSF_CHANNEL_MIN) * mag / 32767;
    }

    if (out < CRSF_CHANNEL_MIN) out = CRSF_CHANNEL_MIN;
    if (out > CRSF_CHANNEL_MAX) out = CRSF_CHANNEL_MAX;
    return (uint16_t)out;
}

// CRSF値をBetaflight側の目安[us]に直す（172→1000us, 1811→2000us）
static unsigned crsf_to_us(uint16_t v) {
    return 1000u + (unsigned)(((int32_t)v - CRSF_CHANNEL_MIN) * 1000
                              / (CRSF_CHANNEL_MAX - CRSF_CHANNEL_MIN));
}

// 現在のスロットル特性を表示する。設定値だけでなく、実際にスティックを
// 倒したときの出力も併記して、飛ばす前に想像がつくようにする。
static void throttle_print_tuning(void) {
    uint16_t hover = throttle_hover_crsf();
    uint16_t top   = throttle_top_crsf();
    printf("# throttle: hover=%u%% (CRSF %u, ~%uus) expo=%u%% up-range=%u%% (top=%u%%)\n",
           (unsigned)throttle_hover_pct, hover, crsf_to_us(hover),
           (unsigned)throttle_expo_pct, (unsigned)throttle_up_range_pct,
           (unsigned)((top - CRSF_CHANNEL_MIN) * 100
                      / (CRSF_CHANNEL_MAX - CRSF_CHANNEL_MIN)));
    const int pcts[5] = { -100, -50, 0, 50, 100 };
    printf("#   thr stick");
    for (int i = 0; i < 5; i++) {
        int32_t stick = (int32_t)pcts[i] * 32767 / 100;
        if (stick < -32768) stick = -32768;
        uint16_t out = throttle_from_position((int16_t)stick);
        // us だけでは判断しづらいのでスロットル%も併記する
        printf("  %+d%%:%uus(%u%%)", pcts[i], crsf_to_us(out),
               (unsigned)((out - CRSF_CHANNEL_MIN) * 100
                          / (CRSF_CHANNEL_MAX - CRSF_CHANNEL_MIN)));
    }
    printf("\n");

    // ロール/ピッチ/ヨーは倒し量に対する舵角の割合で見せる
    printf("# stick expo=%u%% scale=%u%% (roll/pitch/yaw) ->",
           (unsigned)stick_expo_pct, (unsigned)stick_scale_pct);
    const int spcts[4] = { 25, 50, 75, 100 };
    for (int i = 0; i < 4; i++) {
        int32_t in = (int32_t)spcts[i] * 32767 / 100;
        int32_t out = stick_shape((int16_t)in);
        printf("  %d%%:%d%%", spcts[i], (int)(out * 100 / 32767));
    }
    printf("\n");
}

// ラジオ送信機（LiteRadio 3 等）用のマッピング。
// 送信機はスティックではなく AETR のチャンネル順で軸を並べるため、
// ゲームパッドのスティック解釈を挟まず CH1〜 をそのまま素通しする。
//   実測 (2026-08-26, LiteRadio 3 = VID 0483 PID 572B):
//     ch0=X エルロン / ch1=Y エレベーター / ch2=Z スロットル / ch3=Rx ラダー
// スロットルはジンバルが位置を保持するので積算しない（絶対値）。
static void map_radio_to_channels(const gamepad_state_t *gamepad) {
    uint8_t n = gamepad->channel_count;
    if (n > 6) n = 6;  // CH7以降はボタン用に残す
    for (uint8_t c = 0; c < n; c++) {
        crsf_channels[c] = crsf_normalize_channel(gamepad->channels[c]);
    }
    // 送信機のスイッチはボタンとして届くので、CH7〜CH12 は従来通り割り当てる
    crsf_channels[6]  = (gamepad->buttons & GAMEPAD_BTN_A)  ? CRSF_CHANNEL_MAX : CRSF_CHANNEL_MIN;
    crsf_channels[7]  = (gamepad->buttons & GAMEPAD_BTN_B)  ? CRSF_CHANNEL_MAX : CRSF_CHANNEL_MIN;
    crsf_channels[8]  = (gamepad->buttons & GAMEPAD_BTN_X)  ? CRSF_CHANNEL_MAX : CRSF_CHANNEL_MIN;
    crsf_channels[9]  = (gamepad->buttons & GAMEPAD_BTN_Y)  ? CRSF_CHANNEL_MAX : CRSF_CHANNEL_MIN;
    crsf_channels[10] = (gamepad->buttons & GAMEPAD_BTN_LB) ? CRSF_CHANNEL_MAX : CRSF_CHANNEL_MIN;
    crsf_channels[11] = (gamepad->buttons & GAMEPAD_BTN_RB) ? CRSF_CHANNEL_MAX : CRSF_CHANNEL_MIN;
    for (int i = 12; i < CRSF_NUM_CHANNELS; i++) {
        crsf_channels[i] = CRSF_CHANNEL_MID;
    }
}

// ゲームパッド入力をCRSFチャンネルにマッピング
static void map_gamepad_to_channels(const gamepad_state_t *gamepad) {
    // 標準的なドローン操縦マッピング (Mode 2)
    // CH1: Roll     (右スティック X)
    // CH2: Pitch    (右スティック Y) ※反転
    // CH3: Throttle (左スティック Y) ※反転
    // CH4: Yaw      (左スティック X)

    int16_t roll  = gamepad->axes[GAMEPAD_AXIS_RX];
    int16_t pitch = axis_invert(gamepad->axes[GAMEPAD_AXIS_RY]);
    int16_t yaw   = gamepad->axes[GAMEPAD_AXIS_LX];

    // GENERIC時はスティックのストロークが短い分をエクスポ＋舵角スケールで補正する
    if (current_input == INPUT_GENERIC) {
        roll  = stick_shape(roll);
        pitch = stick_shape(pitch);
        yaw   = stick_shape(yaw);
    }

    crsf_channels[0] = crsf_normalize_channel(roll);
    crsf_channels[1] = crsf_normalize_channel(pitch);
    crsf_channels[3] = crsf_normalize_channel(yaw);

    // CH3 Throttle: 入力プロファイルで解釈が変わる
    int16_t stick_up = axis_invert(gamepad->axes[GAMEPAD_AXIS_LY]);  // 上=正
    if (current_input == INPUT_GENERIC) {
        // 自動中央復帰スティック: 中央=ホバリング推力の位置型
        crsf_channels[2] = throttle_from_position(stick_up);
    } else {
        // LiteRadio3: ジンバル位置がそのままスロットル
        crsf_channels[2] = crsf_normalize_channel(stick_up);
    }

    // CH5-8: トリガーとボタン
    // L2トリガー → CH5
    crsf_channels[4] = crsf_normalize_channel(gamepad->axes[GAMEPAD_AXIS_L2]);
    // R2トリガー → CH6
    crsf_channels[5] = crsf_normalize_channel(gamepad->axes[GAMEPAD_AXIS_R2]);

    // ボタンをスイッチチャンネルにマッピング
    // A/Crossボタン → CH7 (Arm): 押下エッジでトグル
    if ((gamepad->buttons & GAMEPAD_BTN_A) && !(prev_buttons & GAMEPAD_BTN_A)) {
        arm_latched = !arm_latched;
        printf("# %s\n", arm_latched ? "ARM" : "DISARM");
    }

    // D-pad上下 = ホバリング推力のトリム（実機プロポのスロットルトリム相当）。
    // バッテリーが減ると同じスロットル%での推力が落ちる（推力∝電圧²）ため、
    // 飛行中にホバリング点が上がっていく。UARTを見ずに親指で補正できるようにする。
    // 押下エッジのみ（押しっぱなしで走らないように）。
    if (current_input == INPUT_GENERIC) {
        if ((gamepad->buttons & GAMEPAD_BTN_DPAD_U) &&
            !(prev_buttons & GAMEPAD_BTN_DPAD_U) && throttle_hover_pct < 100) {
            throttle_hover_pct++;
            printf("# hover trim -> %u%% (~%uus)\n",
                   (unsigned)throttle_hover_pct, crsf_to_us(throttle_hover_crsf()));
        }
        if ((gamepad->buttons & GAMEPAD_BTN_DPAD_D) &&
            !(prev_buttons & GAMEPAD_BTN_DPAD_D) && throttle_hover_pct > 0) {
            throttle_hover_pct--;
            printf("# hover trim -> %u%% (~%uus)\n",
                   (unsigned)throttle_hover_pct, crsf_to_us(throttle_hover_crsf()));
        }
    }

    prev_buttons = gamepad->buttons;
    crsf_channels[6] = arm_latched ? CRSF_CHANNEL_MAX : CRSF_CHANNEL_MIN;
    // B/Circleボタン → CH8
    crsf_channels[7] = (gamepad->buttons & GAMEPAD_BTN_B) ? CRSF_CHANNEL_MAX : CRSF_CHANNEL_MIN;

    // CH9-12: その他のボタン
    crsf_channels[8]  = (gamepad->buttons & GAMEPAD_BTN_X) ? CRSF_CHANNEL_MAX : CRSF_CHANNEL_MIN;
    crsf_channels[9]  = (gamepad->buttons & GAMEPAD_BTN_Y) ? CRSF_CHANNEL_MAX : CRSF_CHANNEL_MIN;
    crsf_channels[10] = (gamepad->buttons & GAMEPAD_BTN_LB) ? CRSF_CHANNEL_MAX : CRSF_CHANNEL_MIN;
    crsf_channels[11] = (gamepad->buttons & GAMEPAD_BTN_RB) ? CRSF_CHANNEL_MAX : CRSF_CHANNEL_MIN;

    // CH13-16: 未使用（中央値）
    crsf_channels[12] = CRSF_CHANNEL_MID;
    crsf_channels[13] = CRSF_CHANNEL_MID;
    crsf_channels[14] = CRSF_CHANNEL_MID;
    crsf_channels[15] = CRSF_CHANNEL_MID;
}

// 入力喪失時（ゲームパッド切断）に送るフェイルセーフ値。
// TXモジュールはリンクを張り続けるため受信機側のfailsafeは効かない。
// こちらで明示的に安全値（スロットル最小・Arm解除・スティック中央）を送る。
static void set_failsafe_channels(void) {
    for (int i = 0; i < CRSF_NUM_CHANNELS; i++) {
        crsf_channels[i] = CRSF_CHANNEL_MID;
    }
    crsf_channels[2] = CRSF_CHANNEL_MIN;  // CH3 Throttle 最小
    crsf_channels[6] = CRSF_CHANNEL_MIN;  // CH7 Arm 解除（最重要: モーター停止）
    // Armトグルもリセット（再接続した瞬間に勝手にArmが復活しないように）
    arm_latched = false;
    prev_buttons = 0;
}

// ========================================
// UART送信
// ========================================

static void crsf_uart_send(const uint8_t *data, size_t len) {
    uart_write_blocking(CRSF_UART, data, len);
}

// 半二重テレメトリドレイン
// Nano TX V2 は S.Port 1本の半二重通信。RCフレーム送信後に
// モジュールが返すテレメトリを読み捨てないと、次回送信時に
// バス衝突が起き ch5〜ch16 が化ける（senderのdrainTelemetry相当）。
static void crsf_drain_telemetry(void) {
    // 送信完了をハードウェア的に保証（最後のビットが線上に出るまで待つ）
    uart_tx_wait_blocking(CRSF_UART);

    // バス上のバイトを読み捨てる。半二重では自分の送信エコーもRX FIFOに
    // 入るため必ず排出する必要がある（放置するとFIFOが溢れる）。
    // 500Hz(2ms)の送信周期を崩さないよう、ドレイン総時間に上限を設ける。
    dbg_drain_len = 0;  // スナップショット用に読み捨てたバイトを記録
    absolute_time_t deadline = make_timeout_time_us(300);  // 最大300us
    int idle_us = 0;
    while (idle_us < 60) {  // 連続60usアイドルで応答途切れと判断
        if (uart_is_readable(CRSF_UART)) {
            uint8_t b = uart_getc(CRSF_UART);
            if (dbg_drain_len < sizeof(dbg_drain_buf)) {
                dbg_drain_buf[dbg_drain_len++] = b;
            }
            idle_us = 0;
        } else {
            if (time_reached(deadline)) {
                break;
            }
            busy_wait_us(10);
            idle_us += 10;
        }
    }
}

// ========================================
// デバッグログ
// ========================================

static void debug_log_channels(void) {
    // ストリーム有効時はヒートビートを抑制（ビューア出力を汚さない）
    if (dbg_stream_enabled) return;

    // 1秒ごとにログ出力
    log_counter++;
    if (log_counter >= (1000 / CRSF_SEND_INTERVAL_MS)) {
        log_counter = 0;

        const gamepad_state_t *gp = usb_gamepad_get_state();

        printf("[%-9s][%s] CH1-4: %4d %4d %4d %4d | BTN: 0x%04X\n",
               status_tag(), gp->connected ? "CONN" : "----",
               crsf_channels[0], crsf_channels[1],
               crsf_channels[2], crsf_channels[3],
               gp->buttons);
    }
}

// ========================================
// 値確認: スナップショット(A) / ストリーム(C) / コマンド
// ========================================

// (A) 1フレームの全処理ポイントをHEX付きでダンプ
//   ① 生HIDレポート → ② デコード後state → ③ CRSFチャンネル
//   → ④ パック後payload → ⑤ フレーム全体+CRC検証 → ⑥ ドレインしたテレメトリ
static void dbg_dump_snapshot(const uint8_t *frame, size_t frame_len) {
    const gamepad_state_t *gp = usb_gamepad_get_state();
    const uint8_t *raw = NULL;
    uint16_t raw_len = usb_gamepad_get_raw_report(&raw);

    printf("\n========== SNAPSHOT ==========\n");

    // ① 生HIDレポート
    printf("(1) HID raw [%u]:", raw_len);
    for (uint16_t i = 0; i < raw_len && raw; i++) printf(" %02X", raw[i]);
    printf("\n");

    // ② デコード後 gamepad_state
    printf("(2) state: LX=%d LY=%d RX=%d RY=%d L2=%d R2=%d BTN=0x%04X conn=%d VID=%04X PID=%04X\n",
           gp->axes[GAMEPAD_AXIS_LX], gp->axes[GAMEPAD_AXIS_LY],
           gp->axes[GAMEPAD_AXIS_RX], gp->axes[GAMEPAD_AXIS_RY],
           gp->axes[GAMEPAD_AXIS_L2], gp->axes[GAMEPAD_AXIS_R2],
           gp->buttons, gp->connected, gp->vid, gp->pid);

    // ②' チャンネル順の生値（送信機用。ディスクリプタに現れた順＝CH1,CH2,…）
    if (gp->channel_count > 0) {
        printf("(2') channels:");
        for (uint8_t c = 0; c < gp->channel_count; c++) {
            printf(" c%u=%d", c + 1, gp->channels[c]);
        }
        printf("\n");
    }

    // ③ CRSFチャンネル（normalize後）
    printf("(3) CRSF ch:");
    for (int i = 0; i < CRSF_NUM_CHANNELS; i++) printf(" %d", crsf_channels[i]);
    printf("\n");

    // ④ パック後payload（22バイト）
    printf("(4) payload[22]:");
    for (int i = 0; i < CRSF_RC_CHANNELS_PACKED_PAYLOAD_SIZE; i++) printf(" %02X", frame[3 + i]);
    printf("\n");

    // ⑤ フレーム全体 + CRC検証
    printf("(5) frame[%u]:", (unsigned)frame_len);
    for (size_t i = 0; i < frame_len; i++) printf(" %02X", frame[i]);
    uint8_t crc_calc = crsf_crc8(&frame[2], CRSF_RC_CHANNELS_PACKED_PAYLOAD_SIZE + 1);
    uint8_t crc_pkt = frame[frame_len - 1];
    printf("\n    SYNC=%02X LEN=%u TYPE=%02X CRC=%02X (calc=%02X %s)\n",
           frame[0], frame[1], frame[2], crc_pkt, crc_calc,
           (crc_pkt == crc_calc) ? "OK" : "NG");

    // ⑥ ドレインしたテレメトリ
    printf("(6) drained telemetry [%u]:", dbg_drain_len);
    for (uint16_t i = 0; i < dbg_drain_len; i++) printf(" %02X", dbg_drain_buf[i]);
    printf("\n==============================\n");
}

// (C) 連続ストリーム: PCビューア向けの1行CSV（プレフィックス "D,"）
//   D,conn,a0..a5,btn,ch0..ch15
static void dbg_stream_frame(void) {
    if (!dbg_stream_enabled) return;
    if (++dbg_stream_counter < DEBUG_STREAM_DECIMATION) return;
    dbg_stream_counter = 0;

    const gamepad_state_t *gp = usb_gamepad_get_state();
    printf("D,%d", gp->connected ? 1 : 0);
    for (int i = 0; i < 6; i++) printf(",%d", gp->axes[i]);
    printf(",%u", gp->buttons);
    for (int i = 0; i < CRSF_NUM_CHANNELS; i++) printf(",%d", crsf_channels[i]);
    printf("\n");
}

// デバッグUART RX(GP5)からのコマンドを処理（非ブロッキング）
static void dbg_poll_commands(void) {
    int c;
    while ((c = getchar_timeout_us(0)) != PICO_ERROR_TIMEOUT) {
        switch (c) {
            case 'd': case 'D':
                dbg_snapshot_request = true;
                break;
            case 's': case 'S':
                dbg_stream_enabled = !dbg_stream_enabled;
                printf("# stream %s\n", dbg_stream_enabled ? "ON" : "OFF");
                break;
            case 'p': case 'P':
                playback_toggle();  // PLAYBACKモードでのみ有効
                break;
            case 'r': case 'R':
                recording_toggle();  // RECORDモードでのみ有効（LBと同じ動作）
                break;
            case 'i': case 'I':
                input_profile_toggle();
                break;
            // --- スロットルの実飛行チューニング ---
            case '[':  // ホバリング推力を下げる（機体が浮きすぎるとき）
                if (throttle_hover_pct > 0) throttle_hover_pct -= 1;
                throttle_print_tuning();
                break;
            case ']':  // ホバリング推力を上げる（機体が沈むとき）
                if (throttle_hover_pct < 100) throttle_hover_pct += 1;
                throttle_print_tuning();
                break;
            case ',':  // エクスポを弱く（線形寄り）
                throttle_expo_pct = (throttle_expo_pct >= 25) ? throttle_expo_pct - 25 : 0;
                throttle_print_tuning();
                break;
            case '.':  // エクスポを強く（3乗寄り）
                throttle_expo_pct = (throttle_expo_pct <= 75) ? throttle_expo_pct + 25 : 100;
                throttle_print_tuning();
                break;
            case '5':  // 上昇方向の可動幅を狭める（上に倒した時の加速が強すぎるとき）
                throttle_up_range_pct = (throttle_up_range_pct >= 10)
                                        ? throttle_up_range_pct - 5 : 5;
                throttle_print_tuning();
                break;
            case '6':  // 同 広げる（上昇が遅くて物足りないとき）
                throttle_up_range_pct = (throttle_up_range_pct <= 95)
                                        ? throttle_up_range_pct + 5 : 100;
                throttle_print_tuning();
                break;
            case '7':  // 舵角を絞る（全体的に効きすぎるときはこちら）
                stick_scale_pct = (stick_scale_pct >= 25) ? stick_scale_pct - 5 : 20;
                throttle_print_tuning();
                break;
            case '8':  // 舵角を戻す
                stick_scale_pct = (stick_scale_pct <= 95) ? stick_scale_pct + 5 : 100;
                throttle_print_tuning();
                break;
            case '9':  // ロール/ピッチ/ヨーのエクスポを弱く
                stick_expo_pct = (stick_expo_pct >= 5) ? stick_expo_pct - 5 : 0;
                throttle_print_tuning();
                break;
            case '0':  // 同 強く（敏感すぎるときはこちら）
                stick_expo_pct = (stick_expo_pct <= 95) ? stick_expo_pct + 5 : 100;
                throttle_print_tuning();
                break;
            case 't': case 'T':
                throttle_print_tuning();
                break;
            case '?':
                printf("# now: %s / input=%s / flash log=%u samples\n",
                       status_tag(), input_name(current_input),
                       (unsigned)recorder_flash_sample_count());
                printf("# commands: d=snapshot  s=toggle stream  r=rec start/stop(RECORD)"
                       "  p=play/stop(PLAYBACK)  i=input profile  ?=help\n");
                printf("# mode button(GP%d): short=cycle mode  long(%.1fs)=play/stop in PLAYBACK"
                       " (green LED: solid=idle  blink=playing)\n",
                       MODE_BTN_PIN, MODE_BTN_LONG_MS / 1000.0);
                printf("# gamepad LB: rec start/stop in RECORD"
                       " (red LED: slow blink=idle  solid=recording  fast=buffer full)\n");
                printf("# input button(GP%d): switch GENERIC(hover-center) <->"
                       " LITERADIO(direct) [now: %s]\n",
                       INPUT_BTN_PIN, input_name(current_input));
                printf("# tuning: [=hover- ]=hover+ ,/.=throttle-expo"
                       " 5/6=throttle-up-range 7/8=stick-scale 9/0=stick-expo t=show\n");
                printf("#   softer: . (throttle expo) / 5 (less climb authority)"
                       " / 7 (less travel) / 0 (more expo)\n");
                break;
            default:
                break;
        }
    }
}

// ========================================
// 初期化
// ========================================

static void init_crsf_uart(void) {
    // CRSF用UART初期化
    uart_init(CRSF_UART, CRSF_BAUD_RATE);
    gpio_set_function(CRSF_UART_TX, GPIO_FUNC_UART);
    gpio_set_function(CRSF_UART_RX, GPIO_FUNC_UART);

    // 8N1設定
    uart_set_format(CRSF_UART, 8, 1, UART_PARITY_NONE);
    uart_set_fifo_enabled(CRSF_UART, true);

#if CRSF_INVERT_SIGNAL
    // Nano TX V2 の S.Port は反転UART。TX出力とRX入力を反転する。
    gpio_set_outover(CRSF_UART_TX, GPIO_OVERRIDE_INVERT);
    gpio_set_inover(CRSF_UART_RX, GPIO_OVERRIDE_INVERT);
    printf("CRSF UART signal inversion: ON\n");
#endif

    printf("CRSF UART initialized: %d bps on GP%d\n", CRSF_BAUD_RATE, CRSF_UART_TX);
}

// デバッグUART(uart1/GP4-5) は stdio_init_all() が CMake の
// PICO_DEFAULT_UART=1 設定に従って初期化するため、ここでの個別初期化は不要。

static void init_led(void) {
    gpio_init(LED_PIN);
    gpio_set_dir(LED_PIN, GPIO_OUT);
    gpio_put(LED_PIN, 0);
}

// ========================================
// モード切替 (ボタン + LED)
// ========================================

static const char* mode_name(op_mode_t m) {
    switch (m) {
        case MODE_SIMPLE:   return "SIMPLE";
        case MODE_RECORD:   return "RECORD";
        case MODE_PLAYBACK: return "PLAYBACK";
        default:            return "?";
    }
}

// 現在のモードに応じて3つの外付けLEDを1つだけ点灯させる。
// 現在のモードと、その中の記録/再生の状態を1語で返す（最大8文字）。
// LEDを見れば分かることだが、ログだけ見返した時に「どのモードのどの状態で
// 起きたことか」が分からないと追えないため、ハートビートと `?` に出す。
static const char* status_tag(void) {
    switch (current_mode) {
        case MODE_RECORD:
            if (recorder_is_full()) return "REC-FULL";  // バッファ満杯で記録停止
            return recording_on ? "REC-ON" : "REC-idle";
        case MODE_PLAYBACK:
            return playback_running ? "PLAY-ON" : "PLAY-idle";
        default:
            return "SIMPLE";
    }
}

static void update_mode_leds(void) {
    gpio_put(LED_RECORD_PIN,   current_mode == MODE_RECORD);
    gpio_put(LED_PLAYBACK_PIN, current_mode == MODE_PLAYBACK);
    gpio_put(LED_SIMPLE_PIN,   current_mode == MODE_SIMPLE);
}

static const char* input_name(input_profile_t p) {
    switch (p) {
        case INPUT_GENERIC:   return "GENERIC(hover-center)";
        case INPUT_LITERADIO: return "LITERADIO(direct)";
        default:              return "?";
    }
}

// 現在の入力プロファイルに応じて2つのLEDを1つだけ点灯させる。
static void update_input_leds(void) {
    gpio_put(LED_INPUT_GENERIC_PIN,   current_input == INPUT_GENERIC);
    gpio_put(LED_INPUT_LITERADIO_PIN, current_input == INPUT_LITERADIO);
}

// RECORDモードの赤LED(GP10)で記録状態を3通りに見せる。
//   待機(未記録) = ゆっくり点滅 / 記録中 = 点灯 / バッファ満杯 = 速い点滅
static void update_record_led(uint32_t now) {
    bool on;
    if (recorder_is_full())  on = (now / 150) % 2;   // 満杯: 速い点滅で警告
    else if (recording_on)   on = true;              // 記録中: 点灯
    else                     on = (now / 600) % 2;   // 待機: ゆっくり点滅
    gpio_put(LED_RECORD_PIN, on);
}

// PLAYBACKモードの緑LED(GP11)で再生状態を2通りに見せる。
//   待機 = 点灯 / 再生中 = 点滅
// モードに入っただけでは点灯のままなので、長押し(or 'p')が受け付けられたことが
// その場で分かる。末尾まで再生して自動停止したら点灯に戻る。
// 内蔵LEDの再生モード表示と同じ周期にして、2つが揃って点滅するようにしている。
static void update_playback_led(uint32_t now) {
    gpio_put(LED_PLAYBACK_PIN, playback_running ? (now / 250) % 2 : 1);
}

static void init_mode_io(void) {
    // ボタン: 入力 + 内部プルアップ（押下でLowに落ちる）
    gpio_init(MODE_BTN_PIN);
    gpio_set_dir(MODE_BTN_PIN, GPIO_IN);
    gpio_pull_up(MODE_BTN_PIN);

    // 入力プロファイル切替ボタン: 同上
    gpio_init(INPUT_BTN_PIN);
    gpio_set_dir(INPUT_BTN_PIN, GPIO_IN);
    gpio_pull_up(INPUT_BTN_PIN);

    // モードLED: 出力
    gpio_init(LED_RECORD_PIN);   gpio_set_dir(LED_RECORD_PIN,   GPIO_OUT);
    gpio_init(LED_PLAYBACK_PIN); gpio_set_dir(LED_PLAYBACK_PIN, GPIO_OUT);
    gpio_init(LED_SIMPLE_PIN);   gpio_set_dir(LED_SIMPLE_PIN,   GPIO_OUT);

    // 入力プロファイルLED: 出力
    gpio_init(LED_INPUT_GENERIC_PIN);
    gpio_set_dir(LED_INPUT_GENERIC_PIN, GPIO_OUT);
    gpio_init(LED_INPUT_LITERADIO_PIN);
    gpio_set_dir(LED_INPUT_LITERADIO_PIN, GPIO_OUT);

    update_mode_leds();
    update_input_leds();
}

// 入力プロファイルを切り替える。スロットルの解釈が変わるため、
static void input_profile_toggle(void) {
    current_input = (input_profile_t)((current_input + 1) % INPUT_PROFILE_COUNT);
    update_input_leds();
    printf("# input -> %s\n", input_name(current_input));
}

// 入力プロファイル切替ボタン（GP6）をポーリング。短押しでトグル。
static void poll_input_button(void) {
    bool raw = (gpio_get(INPUT_BTN_PIN) == 0);  // 押下=true
    uint32_t now = to_ms_since_boot(get_absolute_time());

    if (raw != ibtn_pressed_state && (now - ibtn_last_change_ms) >= INPUT_BTN_DEBOUNCE_MS) {
        ibtn_last_change_ms = now;
        ibtn_pressed_state = raw;
        if (!raw) {  // 離したときに確定（押しっぱなしでの連続切替を防ぐ）
            input_profile_toggle();
        }
    }
}

// モードを1つ進め、記録の開始/停止など遷移に伴う処理を行う（短押し時）。
static void mode_advance(void) {
    op_mode_t prev = current_mode;
    current_mode = (op_mode_t)((current_mode + 1) % MODE_COUNT);
    update_mode_leds();
    printf("# mode -> %s\n", mode_name(current_mode));

    // RECORDから抜けたら記録を止め、録れていればフラッシュへ書き出す。
    // LBを押さずに通過しただけなら書かない（SIMPLE→RECORD→PLAYBACKと
    // 循環するだけで保存済みログを空ログに潰してしまわないように）。
    if (prev == MODE_RECORD && current_mode != MODE_RECORD) {
        recording_on = false;
        if (rec_dirty) {
            size_t n = recorder_stop_and_flush();
            printf("# recording stopped, flushed %u samples to flash\n", (unsigned)n);
        } else {
            printf("# nothing recorded, flash log kept (%u samples)\n",
                   (unsigned)recorder_flash_sample_count());
        }
    }
    // RECORDに入ったら「待機」から始める（記録開始はLB or 'r'）
    if (current_mode == MODE_RECORD && prev != MODE_RECORD) {
        recorder_init();       // バッファを空にする
        recording_on = false;
        rec_dirty = false;
        printf("# RECORD ready: press LB (or 'r') to start/stop recording\n");
    }
    // PLAYBACKに入ったら再生を待機状態にし、保存済みサンプル数を表示
    if (current_mode == MODE_PLAYBACK) {
        playback_running = false;
        pb_sample_idx = 0;
        pb_frame_ctr = 0;
        printf("# playback ready: %u samples in flash (long-press or 'p' to play)\n",
               (unsigned)recorder_flash_sample_count());
    }
}

// ボタンをポーリング（非ブロッキング）。
//   短押し（長押し未満で離す）= モードを1つ進める
//   長押し（MODE_BTN_LONG_MS 保持）= PLAYBACK中なら再生start/stop
// 長押し中はモード循環を抑止する。
static void poll_mode_button(void) {
    bool raw = (gpio_get(MODE_BTN_PIN) == 0);  // 押下=true
    uint32_t now = to_ms_since_boot(get_absolute_time());

    // デバウンス後の状態変化を確定
    if (raw != btn_pressed_state && (now - btn_last_change_ms) >= MODE_BTN_DEBOUNCE_MS) {
        btn_last_change_ms = now;
        btn_pressed_state = raw;
        if (raw) {
            // 押下開始: まだ何もしない（短/長を離すまで/しきい値で判定）
            btn_press_start_ms = now;
            btn_long_fired = false;
        } else {
            // 離した: 長押しが発火していなければ短押し = モード循環
            if (!btn_long_fired) {
                mode_advance();
            }
        }
    }

    // 保持中に長押ししきい値を超えたら一度だけ長押しアクション
    if (btn_pressed_state && !btn_long_fired &&
        (now - btn_press_start_ms) >= MODE_BTN_LONG_MS) {
        btn_long_fired = true;  // 短押し扱いを抑止
        if (current_mode == MODE_PLAYBACK) {
            playback_toggle();
        }
    }
}

static void init_channels(void) {
    // 全チャンネルを安全な初期値に設定
    // スロットルは最小、他は中央
    for (int i = 0; i < CRSF_NUM_CHANNELS; i++) {
        crsf_channels[i] = CRSF_CHANNEL_MID;
    }
    // スロットル（CH3）は最小値
    crsf_channels[2] = CRSF_CHANNEL_MIN;
}

// ========================================
// メインループ
// ========================================

int main() {
    // stdio初期化（デバッグUARTへ出力）
    stdio_init_all();

    printf("\n");
    printf("========================================\n");
    printf("  ExpressLRS Realtime Recorder\n");
    printf("========================================\n");
    printf("\n");

    // 初期化
    init_led();
    init_mode_io();
    init_channels();
    init_crsf_uart();
    recorder_init();
    usb_gamepad_init();

    printf("Mode: %s (press GP%d button to cycle)\n", mode_name(current_mode), MODE_BTN_PIN);
    printf("Input: %s (press GP%d button to switch)\n", input_name(current_input), INPUT_BTN_PIN);

    printf("USB Host initialized, waiting for gamepad...\n");
    printf("\n");

    // CRSFパケットバッファ
    uint8_t crsf_packet[CRSF_MAX_PACKET_SIZE];

    while (1) {
        // TinyUSB Hostタスク処理
        usb_gamepad_task();

        // デバッグUARTからのコマンド処理（d=snapshot, s=stream, ?=help）
        dbg_poll_commands();

        // モード切替ボタン（GP2）・入力プロファイル切替ボタン（GP6）のポーリング
        poll_mode_button();
        poll_input_button();

        // 現在時刻を取得
        uint32_t now = to_ms_since_boot(get_absolute_time());

        // CRSF送信間隔チェック
        if (now - last_crsf_send_time >= CRSF_SEND_INTERVAL_MS) {
            last_crsf_send_time = now;

            // ゲームパッド状態を取得
            const gamepad_state_t *gamepad = usb_gamepad_get_state();

            // 記録トリガー(LB): RECORD中のみ記録のON/OFFを切り替える
            poll_record_trigger(gamepad);

            // 再生中に送出するフラッシュサンプル（無ければNULL）
            const uint8_t *pb_payload = NULL;

            switch (current_mode) {
                case MODE_SIMPLE:
                case MODE_RECORD:
                    // 単純/記録: ゲームパッド入力を channels にマッピング
                    if (gamepad->connected) {
                        // LITERADIOプロファイル かつ チャンネル順の軸が取れている
                        // 送信機は素通し。それ以外はゲームパッドとして解釈する。
                        if (current_input == INPUT_LITERADIO &&
                            gamepad->channel_count >= 4) {
                            map_radio_to_channels(gamepad);
                        } else {
                            map_gamepad_to_channels(gamepad);
                        }
                        gpio_put(LED_PIN, 1);  // 接続中: 内蔵LED点灯
                    } else {
                        // 未接続: フェイルセーフ値を送出（スロットル最小・Arm解除）。
                        // 最後の値を送り続けると機体がリンク正常と誤認するため。
                        set_failsafe_channels();
                        gpio_put(LED_PIN, (now / 500) % 2);  // 点滅
                    }
                    // 記録: トリガーONの間だけ現在の16chを記録器へ
                    //（内部で50Hz間引き＋ボタンラッチ）
                    if (current_mode == MODE_RECORD) {
                        if (recording_on) {
                            recorder_on_frame(crsf_channels);
                        }
                        update_record_led(now);
                    }
                    break;

                case MODE_PLAYBACK:
                    if (playback_running) {
                        pb_payload = recorder_flash_sample(pb_sample_idx);
                    }
                    if (pb_payload == NULL) {
                        // 停止中/データ無し: 安全側（スロットル最小・他中央）を送出
                        for (int i = 0; i < CRSF_NUM_CHANNELS; i++) {
                            crsf_channels[i] = CRSF_CHANNEL_MID;
                        }
                        crsf_channels[2] = CRSF_CHANNEL_MIN;
                    }
                    gpio_put(LED_PIN, (now / 250) % 2);   // 速い点滅=再生モード
                    update_playback_led(now);             // 緑: 点滅=再生中 / 点灯=待機
                    break;

                default:
                    break;
            }

            // CRSFパケットを生成して送信
            //   再生中は記録済みpayloadをそのままフレーム化、それ以外はchannelsから生成
            size_t len = pb_payload
                ? crsf_build_frame_from_payload(pb_payload, crsf_packet)
                : crsf_build_rc_channels_packet(crsf_channels, crsf_packet);
            crsf_uart_send(crsf_packet, len);

            // 半二重バス上のテレメトリ応答を読み捨てて衝突を防ぐ
            crsf_drain_telemetry();

            // 再生の50Hz送出: REC_DECIMATION フレームごとに次サンプルへ
            if (pb_payload) {
                if (++pb_frame_ctr >= REC_DECIMATION) {
                    pb_frame_ctr = 0;
                    if (++pb_sample_idx >= recorder_flash_sample_count()) {
                        pb_sample_idx = 0;
                        playback_running = false;  // 末尾まで再生したら停止
                        printf("# playback finished\n");
                    }
                }
            }

            // (C) 連続ストリーム（有効時のみ、間引き出力）
            dbg_stream_frame();

            // (A) スナップショット要求があれば全段ダンプ
            if (dbg_snapshot_request) {
                dbg_snapshot_request = false;
                dbg_dump_snapshot(crsf_packet, len);
            }

            // デバッグログ（1秒ごとのヒートビート）
            debug_log_channels();
        }
    }

    return 0;
}

#else
// ========================================
// ホストPC用スタブ（テスト用）
// ========================================

int main() {
    printf("ExpressLRS Realtime Recorder\n");
    printf("This is a Pico application. Build with Pico SDK.\n");
    printf("\n");
    printf("To build for Pico:\n");
    printf("  export PICO_SDK_PATH=/path/to/pico-sdk\n");
    printf("  mkdir build && cd build\n");
    printf("  cmake ..\n");
    printf("  make\n");
    return 0;
}

#endif // PICO_BOARD
