akiihito/expresslrs_realtime_recorder/(commit log)

2026-08-26 Soften accumulator throttle after first flight: slower, with expo
    First flight (2026-08-27) found the accumulator throttle unflyable.
    Two causes, both in the curve rather than the mechanism:
    - 2.0s full travel is too fast. A whoop's usable hover band is only
    ~15% of the range, which full stick crosses in 0.3s -- about human
    reaction time, so the target value cannot be caught.
    - Rate was linear in deflection, so even small stick movements moved
    throttle quickly, leaving no fine control near hover. An integrator
    under closed-loop human control then overshoots and oscillates.
    Slow the default to 3.5s and shape the rate with 75% cubic expo:
    full 28.5%/s, half 6.2%/s, quarter 2.1%/s (wa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
    [main.c]
2026-08-27 Replace accumulator throttle with hover-centered position control
    The accumulator was unflyable and tuning the curve did not fix it,
    because the problem is structural. Throttle reaches height through
    two integrations already (thrust -> vertical speed -> height); a real
    transmitter maps stick position straight to thrust, so the pilot
    closes a loop around two integrators. Accumulating stick deflection
    inserted a third, which a human cannot fly.
    Map position to thrust instead, putting hover at stick center so a
    self-centering stick still works:
    bottom -> CRSF min / center -> hover thrust / top -> CRSF max
    Deflection now sets climb/descent rate and releasing the stick
    returns to hover, so a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
    [main.c]
2026-08-27 Lower default hover thrust to 30% and warn to tune upward only
    Releasing the stick now commands hover thrust, so a hover value set
    above the airframe's real hover makes letting go climb -- the
    instinctive panic reaction stops being the safe one. Too low only
    means it will not lift, so the default belongs on the low side.
    45% was a generic guess; drop it to 30% (~1300us) and document that
    the value must be found by starting low and raising with ']'.
    Verified on hardware that the mapping itself is correct: across four
    release cycles CH3 tracked the stick smoothly from 188 (1010us, stick
    down) to exactly 909 (1449us, hover at the old 45%) and never went
    higher. The reported 'motors at full' w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
    [main.c]
2026-08-27 Add per-profile stick expo for roll/pitch/yaw on the gamepad
    A gamepad stick has a far shorter throw than a transmitter gimbal, so
    the same thumb movement is a much larger fraction of full deflection
    and the quad rotates from the smallest input (first flight, 2026-08-27).
    That is a property of the input device, not the aircraft, so correct
    it per input profile rather than through Betaflight rates -- rates are
    shared and would also apply when flying the same quad with the
    LiteRadio, whose gimbals do not need it. Applies to GENERIC only.
    Defaults to 50% and shares the throttle's expo curve, now factored out
    as apply_expo(). Tunable live over the debug UART with 9 / 0, and the
    readout shows o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
    [main.c]
2026-08-27 Add stick travel scale; expo alone cannot tame full-stick authority
    Expo only reshapes the curve -- full deflection still commands full
    rate -- so a quad that is too responsive overall cannot be fixed with
    expo no matter how far it is pushed. Add a travel scale (default 60%)
    that attenuates roll/pitch/yaw output directly, equivalent to lowering
    Betaflight rates but settable per input profile and tunable in flight
    (7 / 8).
    The readout now shows expo and scale together, and the help line spells
    out which key softens which axis: the previous flight had both expo
    values driven to 0%, the sharpest setting, while trying to soften them.
    [main.c]
2026-08-27 Fix stale 'accum' label in profile name and help text
    GENERIC has been hover-centered position control since 5646333.
    [main.c]
2026-08-27 Bake in the in-flight stick tuning reached so far (expo 85%, scale 35%)
    Read back off the running board before the drone battery ran out, so
    the next session starts where this one stopped instead of at the
    untested defaults. Roll/pitch/yaw now give 1/6/16/34% output at
    25/50/75/100% deflection.
    Tuning is not finished: hover thrust is still at the untried 20%
    default and needs to be found by flying. Recorded as such in
    CLAUDE.md.
2026-08-27 Add D-pad hover trim so throttle can be corrected in flight
    Thrust falls with the square of pack voltage, so the hover point
    climbs several percent over a flight. A real transmitter hides this
    because its throttle stick holds position and the pilot's hand tracks
    the drift; a self-centering stick pinned to a fixed hover value cannot.
    Map D-pad up/down to +/-1% hover trim -- the same job as a radio's
    throttle trim -- so it can be corrected with the thumb mid-flight
    without reading the UART. Press-edge only, GENERIC profile only, and
    reset on power cycle so each pack starts from the baseline.
    Barometric altitude hold is not an option here: the FC has no baro,
    and indoor hops of about a metre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
    [main.c]
2026-08-27 Add a printable controls reference sheet
    Collects every control in one place: the GP2/GP6 buttons and LEDs,
    the gamepad and LiteRadio stick/button mappings with their CRSF and
    AUX numbers, all debug-UART keys, and the arm/flash/monitor
    procedures. Laid out for A4 print with the safety notes -- arm with
    throttle held down, switch profiles for the LiteRadio, and which
    tuning keys soften versus sharpen -- boxed so they stand out.
2026-08-27 Add a verified KiCad schematic for the board
    Captures the breadboard wiring as a real schematic so the PCB artwork
    can be laid out from it. Generated from the KiCad standard libraries
    with tools/gen_sch.py and checked rather than eyeballed: ERC reports
    0 errors and 0 warnings, and the exported netlist was compared
    net-by-net against the intended wiring.
    Two deliberate departures from the breadboard, both called out in
    hardware/README.md: GP1 is tied to the CRSF bus (the half-duplex form
    the firmware's drain logic and the R63b reference both assume, where
    the bench build left it floating), and SW3 is included so the board
    has a spot for the GP3 arm switch whose firmware is written but
    curren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
    [recorder.kicad_sch]
2026-08-27 Reflect the input-profile button and LEDs in the perfboard layout
    The floorplan was drawn when the board only had the mode button and
    three mode LEDs; GP6, GP13 and GP14 were added to the design later
    and the diagram was never updated, so soldering to it would have left
    out the input-profile switch and its two indicators.
    Adds them to the pin map, the floorplan (BTN2 at pin 9, LED block
    extended to five, skipping the pin-18 ground row), the netlist table
    and the pin table. The GP3 arm switch is deliberately still absent.
    Also corrects two notes that Stage D has since settled: inversion and
    the half-duplex wiring are confirmed working rather than undecided,
    and the 680R is no longer marked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
2026-08-27 Add the fuse and decoupling capacitors the schematic was missing
    The circuit had no passives on the power rails at all. They are cheap
    insurance and awkward to retrofit once a board exists, so add them
    before layout:
    - F1 in series on LiPo+ ahead of everything (2A as a starting value;
    the real rating needs measuring)
    - C1 470uF/25V + C2 100nF on the VBAT rail, for the voltage dip when
    the TX module transmits. 25V so a full 3S pack has margin.
    - C3 100uF/16V + C4 100nF on the 5V rail, for gamepad inrush
    Verified the same way as before: ERC clean, and the netlist confirms
    F1 is genuinely in series (J3.1 -> F1 -> VBAT_7_13V) rather than
    bridged across it, with every capacitor between its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
    [recorder.kicad_sch]
2026-08-27 Add 5V TVS and a series resistor on GP1, plus a design review pass
    Requested TVS (D6) across the 5V rail: if the buck fails short, 12V
    reaches the rail at a current the fuse considers normal, so nothing
    disconnects it. D6 conducts and pulls enough current to blow F1. Uses
    a bidirectional part to match KiCad's bidirectional TVS symbol, which
    also removes a polarity to get wrong at assembly. Documented honestly:
    its ~9V clamp is above the Pico's 5.5V maximum, so this ends the fault
    rather than saving the Pico.
    Review of the rest turned up one more thing worth a part: GP1 ran
    straight to the CRSF bus with no resistor, so plugging J1 in backwards
    would put up to 13V directly on a GPIO (GP0 at l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
    [recorder.kicad_sch]
2026-08-27 Correct the reverse-polarity note: LiPo connectors are keyed
    Standard LiPo connectors are all polarised, so the pack cannot be
    mated backwards -- the note overstated the risk. What remains is an
    assembly error on the board side (connector soldered the wrong way
    round, pigtail wired red/black reversed), which a meter check before
    first power-up catches.
    Also collects the measurements that have to happen before layout:
    which LiPo connector the pack actually uses, the buck module's real
    dimensions, and the armed current draw that sets the fuse rating.
2026-08-27 Correct how to measure current for the fuse rating
    Said to measure 'when armed', which is wrong: arming raises current on
    the aircraft, drawn from its own pack. F1 protects the ground side,
    which transmits at 500Hz regardless of arm state, so that number
    barely moves. What actually dominates is the TX output power setting.
    Rewrites the note with the measurement that matters -- worst case at
    the power level actually flown -- and how to take it: read the bench
    PSU's own current display, or put a meter in series on LiPo+ using the
    10A jack. Adds picking 1.5-2x and a slow-blow so buck inrush does not
    trip it on every power-up.
2026-09-30 Design the PCB: 105x85mm two-layer board, DRC clean
    Lays out and routes the board from the existing schematic. Generated
    by script the same way the schematic was, and checked mechanically
    rather than by eye: DRC reports 0 violations and 0 unconnected items,
    and Gerber export succeeds.
    Layout choices that made the routing tractable:
    - Everything is through-hole, so the bottom-side ground pour reaches
    every GND pad directly -- no ground tracks and no vias anywhere.
    - Parts that land on the Pico's left pin row sit to its left and the
    buck (VBUS) to its right, so nothing has to cross the module.
    - Left-hand parts are placed at the same Y as the pin they serve, so
    those nets are straight h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
    [recorder.kicad_pcb, recorder.kicad_sch]
2026-09-30 Fit the real MP1584EN buck module: custom footprint and re-layout
    The module arrived, so J2 is no longer a placeholder header. Derived
    its footprint from the product photos by measuring the pad positions
    in the image rather than eyeballing them: eight holes in four pairs,
    board 22.3x16.8mm, columns at +/-9.45mm and rows at +/-6.70/4.16mm
    with the expected 2.54mm pair pitch, symmetric about the centre.
    Pin orientation comes from both photos agreeing: the underside silk
    reads OUT-/IN- over OUT+/IN+, which mirrors to IN on the left and OUT
    on the right seen from the component side, matching the board's own
    +/- marks sitting on the output end.
    Moving to a 22.3mm-wide part meant re-placing J2 (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
    [recorder.kicad_pcb, recorder.kicad_sch]
2026-09-30 Add a perfboard build plan for the current circuit
    Asked for a perfboard build before committing to a PCB. Places the
    verified circuit on a 2.54mm grid and derives the wiring list from the
    netlist, so nothing can be left out: every net's holes are listed and
    the generator refuses to emit unless every pin in the netlist has a
    hole and no two pins share one.
    Board needs 35x26 holes; notes to count the holes on the actual board
    rather than trust the catalogue size, since the border eats some.
    Calls out the things that only bite on perfboard: the buck module's
    18.9mm hole spacing is 7.44 holes so it cannot be plugged in and needs
    flying leads, tact switches must use the diagonal pair, and GND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
2026-10-01 Add a solder-side view and wiring technique to the perfboard plan
    The placement diagram is drawn from the component side, but all the
    wiring happens on the back, where the columns run the other way --
    an easy way to wire the whole board mirrored. Adds the same grid
    flipped, with the warning that row numbers stay put and only columns
    reverse.
    Also says what to wire each net with: bare tinned wire for the ground
    bus, insulated for power and signals, and which five connections are
    adjacent enough to bridge with a bent component leg instead of wire.
    [gen_perf.py]
2026-10-14 Record that playback worked end to end on hardware
    Record -> flash -> playback runs through from the buttons alone and
    reaches the end. Stage E's first four steps pass; failsafe was already
    covered back in Stage D.
    Notes what this run did not establish, since the serial was not
    captured: whether the sample count matches 50Hz x duration, whether
    the replayed values match what was recorded, and whether the
    recording survives a power cycle. One captured run next time closes
    all three.
2026-10-14 Note the request to start and stop recording at will
    Today's flight showed the problem: recording spans the whole time in
    RECORD mode, so the fumbling with the mode button lands inside the
    take, and the boundaries are hard to find.
    Writes up the options for a dedicated trigger and, more importantly,
    the constraint that shapes the design: stopping must not flush. A
    flash write stalls XIP and breaks the 500Hz stream, so doing it
    mid-flight would drop the aircraft. Stop only halts appending to RAM;
    the flush stays where it is, on leaving RECORD mode. That also means
    no recorder API change -- just gate recorder_on_frame().
2026-10-14 Pick LB as the recording trigger
    A shoulder button is pressed with the index finger, so recording can
    be started mid-flight without lifting a thumb off a stick, which a
    face button would require. Left shoulder specifically, to keep it on
    the opposite hand from Arm (A, right thumb) and avoid confusing the
    two under pressure.
2026-10-20 Start and stop recording from the LB button
    RECORD mode now begins idle and the LB press edge toggles recording,
    so the fumbling with the mode button no longer lands inside a take.
    Each start clears the buffer (option A). Stopping only halts the
    appends; the flush stays on leaving RECORD, and is skipped when LB was
    never pressed, so cycling through RECORD on the way to PLAYBACK no
    longer overwrites a good log with a fragment.
    The trigger keeps its own button latch instead of sharing
    prev_buttons, which only updates on the gamepad mapping path and would
    leave the trigger dead under the LITERADIO profile.
    The LEDs now say which state the firmware is in: red slow-blinks while
    idle, is solid w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
    [main.c]
2026-10-20 Bring the stale docs back in line with the firmware
    README was the worst of it: the build steps omitted
    scripts/apply_sdk_patch.sh, without which the F310 returns no HID
    reports at all, and PICO_TOOLCHAIN_PATH, without which the link fails.
    It also still described the pre-2026-08-27 throttle, listed neither
    the input profiles nor the devices actually in use, and pointed at the
    superseded perfboard layout.
    hardware-validation.md was worse in one spot: section 3.5 still
    asserted the accumulator throttle ("hold it up and CH3 keeps climbing,
    centre holds the value") as the pass condition, so running the
    checklist today would fail every item. Section 5 still treated the
    CRSF inversion as an open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
2026-10-20 Cap the throttle's travel above hover
    Today's flight: centre barely lifts the aircraft, then a small push up
    accelerates so hard it cannot be controlled. The cause is asymmetry.
    Hover sits below centre (20%), so sending CRSF maximum at the top of
    the stick gives the up half 80 throttle points against the down half's
    20 -- four times the gain -- and thrust goes roughly as the square of
    throttle, which makes an increase from a low hover point harsher
    still. Taking thrust as proportional to throttle squared and hover as
    1g, half stick up was +1.95g net, three times the thrust needed to
    hover.
    The top of the stick now maps to hover plus 15 points of the CRSF
    range instead of the maximum. Half s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
2026-10-20 Keep the docs from going stale again
    Today's audit found README and the validation checklists months out of
    date, in ways that bite: the build steps omitted the SDK patch without
    which the F310 stays silent, and section 3.5 still asserted the
    accumulator throttle as a pass condition, so running the checklist
    would fail every item.
    The cause is duplication. One fact -- GP10, 921600 -- is written in six
    documents, so a one-line code change needs up to six edits, and the
    only one open while working is CLAUDE.md. The other five go unnoticed
    until the next person is confused by them: code tells you when it is
    wrong by failing, a document never does. CLAUDE.md now carries a rules
    section with a t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
    [check_docs.py]
2026-10-20 Record today's bench verification of the LB trigger and playback LED
    RECORD entry blinks the red LED slowly, LB turns it solid, a second
    press returns it to blinking, leaving the mode flushes, and a long
    press in PLAYBACK turns the green LED from solid to blinking. All as
    specified.
    Four things the run did not cover, left open rather than ticked: that
    flushed N over 50 matches the seconds recorded (nobody counted), that
    replayed values match recorded ones (no serial log kept), persistence
    across a power cycle, and the two refusal paths -- passing through
    RECORD without pressing LB, and playback on an empty flash, which
    could not be tried because the flash already held a log.
    Co-Authored-By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
2026-10-20 Show the current mode on the serial log
    There was no way to ask the firmware which mode it is in: the mode was
    printed only at boot and on each change, so after a few button presses
    the only answer was to press GP2 and read the transition -- which
    advances the mode. The LEDs say it, but a log read back later does not,
    and that is exactly when it matters: knowing which mode and which
    state something happened in.
    The one-second heartbeat now leads with the state and '?' prints it on
    its first line, together with the input profile and how many samples
    the flash log holds. The tag distinguishes the sub-states the LEDs
    already show, so REC-idle, REC-ON and REC-FULL are separate, as are
    PLAY-idle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
2026-10-20 Leave the next session a starting point
    The firmware on the Pico is f452ca0, flashed before the throttle fix
    existed, so the first item is to flash: flying as it stands reproduces
    the +1.95g at half stick that today's session was about. That one is
    easy to miss, since the recording and playback work that was verified
    today is on the board and feels current.
    The rest is the in-flight throttle tuning this is all for, the five
    checks left unverified -- two of which fall out of a single serial
    capture -- and a pointer to the Arm switch waiting on parts.
2026-10-23 Make the parts list specific enough to order from
    The table named parts by function, not by what a shop sells: J1 through
    J4 were "3ピン" and "2ピン", F1 was "ヒューズ 2A", and the LED row read
    "赤/緑/青/×2", which reads as two of each rather than five LEDs in all.
    Nothing in it said what to type into a search box.
    The sizes and pitches now come from the KiCad footprints, so the table
    and the board agree: J1 is a JST XH 3P, J3 a pigtail soldered to pads
    7mm apart, F1 a mini blade holder, SW1/SW2 6mm tact switches and SW3 a
    DIP slide switch. Both boards use the same parts, so the one table
    serves the PCB and the hand-built version, with the universal board,
    the 2x20 socket header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
2026-10-27 Put the Akizuki order codes in the parts table
    Ordering meant looking every part up again, and the table said nothing
    about where to buy. The codes now sit in the table itself rather than in
    a second shopping list, so there is still one place to change when a
    part changes, and the four parts Akizuki does not stock -- the Pico, the
    buck module, the LiPo pigtail and the mounting hardware -- say where
    they do come from instead of a code.
    Checking the catalogue turned up things worth writing down next to the
    parts they bite. Akizuki has no 3mm pure blue except in hundreds, so D3
    falls back to a 505nm blue-green. The tact switch legs sit 6.5 by 4.5mm
    apart, which is no multiple of 2.54, so on pe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
2026-10-27 Settle the transmitter-side battery on 3S
    The parts table said to match J3's connector to "the aircraft's
    battery", which reads as if the pack in the quad gets reused. It
    cannot: the quad flies away with it, and J3 feeds the Nano TX and the
    buck on the ground. The row now says so, and the cell count is settled
    at 3S -- 2S sags to the module's 7V floor at the end of a discharge,
    while a full 3S at 12.6V stays under the 13V ceiling and matches the
    12V bench supply the breadboard has been running on all along. That
    leaves only the connector open, and that is a purchase-time choice
    about sharing a charger with the quad's packs, not a measurement, so it
    moves out of the measure-first list.
    The s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
2026-11-02 Delete the superseded perfboard layout
    docs/perfboard-layout.html predated the protection parts -- the 680R in
    series with GP0, the 1k on GP1, the 5V TVS and the fuse -- so building
    from it produced a board missing every one of them. It has carried a
    "do not use" banner since, and three documents carried a warning
    pointing at it, which is the arrangement the development rules describe
    as the thing that keeps a dead file alive: each warning is itself a
    reference, so the file stays reachable and someone eventually opens it.
    perfboard.html has been the current sheet for a while and its wiring
    list is generated from the netlist, so there is nothing in the old file
    to keep. The three warnings go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
2026-11-03 Move F1 to the bottom right, where a fuse holder can actually sit
    Neither board-mount holder fits a 2.54mm perfboard: the mini blade one
    (Akizuki 118222) has φ1.78mm pins 9.92 x 3.4mm apart, and the midget
    glass clip (110521 / FUC-03A) has φ1.7mm legs 6.7mm apart. Perfboard
    holes are about 1mm. So the hand-built version wants an inline holder
    in the LiPo+ lead, and whatever is board-mounted needs lead wires plus
    glue — which needs room the bottom-left strip did not have.
    J3 moves with F1. Leaving it at the bottom left would stretch the
    unfused LiPo+ segment across the whole board, under the LED column,
    which is the one wire the fuse cannot protect.
    Also fold last session's hand edits t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
2026-11-03 Stand F1 up in the free block right of the Pico
    The bottom-right strip only had 4 rows of depth before it ran into the
    Pico, which is tight for a 13 x 7mm holder. Moving F1 to (33,20)-(33,24)
    puts it in 列31-35 x 行18-25 — 17.8 x 20.3mm, enough to stand the holder
    up, and at the board edge so a finger can reach in to change the fuse.
    Not the middle of the board, which is the larger free area (列11-19 x
    行11-25, 135 holes) but is where the 13 nets leaving the Pico's left
    column fan out. Putting F1 there means dragging two 7-13V wires across
    the signal corridor; a chafe onto a GPIO line is a dead Pico. Written
    down in the perfboard notes so the next person does not re-propose it.
    Co-Au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
    [gen_perf.py]
2026-11-03 Plan the GND bus properly and check it at generation time
    "列19 + 行25" left 12 of the 25 GND points with nowhere to go, the five
    LED cathodes among them. Replaced with six lanes (A-F) that reach 20 of
    25 directly or one hole away; the remaining five are listed with their
    distance to the nearest lane.
    The lanes are bare tinned wire, so a lane crossing a hole that belongs
    to another net is a short. GND_BUS now lives next to `place`, and
    generation fails if any lane pierces a foreign pin — verified by moving
    SW2 onto lane F, which stops the build with the offending hole.
    That check is also why trunk A stops at 列30 instead of running the full
    width: (33,24) F1.2 and (35,26) J3.1 are the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
    [gen_perf.py]
2026-11-03 Put the capacitors back in the parts table, and catch this next time
    a2d92d4 dropped the F1 holder comparison between the F1 row and the C1
    row of the parts table. Markdown ends a table at the first non-row line,
    so C1, C2/C4, C3 and H1-H4 stopped being a table and rendered as raw
    "| C1 | 1 | ..." text — which reads as the capacitors not being
    specified at all. Moved the subsection below the table.
    That is the kind of break nobody sees while editing, so check_docs.py
    now has five more checks, each one from a defect that actually happened:
    4. the VALUE behind *_DEFAULT_PCT, not just the name. CLAUDE.md had
    STICK_EXPO_DEFAULT_PCT as 85% in two places and 50% in a third;
    main.c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
2026-11-03 Say which hole is plus, and what actually makes the 100nF work
    The notes said C1 and C3 have polarity but never said which way round,
    the same gap the LEDs had. C1 is plus at (13,26), C3 at (30,12), both
    the left hole; the figures now derive those from `place`, so they
    follow if the parts move.
    The side-by-side pairs are correct — C1/C2 are both across VBAT and
    GND, C3/C4 both across +5V and GND, confirmed against the netlist. The
    page now says why two values sit next to each other, since the layout
    invites the question.
    Replaced "connect it with thick wire" for C2/C4. Thickness does almost
    nothing here; loop inductance does, and that goes with length. Measured
    from the layout, C2 is 91m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
    [gen_perf.py]
2026-11-03 Give the capacitors their own orientation table
    Which hole is plus was buried in a sentence and only covered C1 and C3.
    Now all four are in a table with the rail name, and polarity comes from
    the footprint (CP_ is polarized) rather than being typed in, so it
    cannot drift from the schematic.
    The table says the left/right it means is the component-side figure.
    The solder-side figure runs columns the other way, and an electrolytic
    put in backwards from that view is the kind of mistake that only shows
    up as a bang.
    [gen_perf.py]
2026-11-03 Run the bottom row left to right: J3, F1, C1, C2
    J3 was cramped because F1's reserved block (列31-35 x 行18-25) sat
    directly over its holes on 行26 — you would solder the pigtail and then
    glue the holder on top of it, with no way back. My doing.
    The fix is the arrangement this started from. 行26 now reads
    (4,26) J3 → (6,26) F1 (10,26) → C1 → C2, which is the direction the
    current flows and is why C1 and C2 have their plus on the left.
    The reason I moved it right two commits ago was body space, and that
    reason was weaker than I thought: neither board-mount holder fits
    perfboard holes at all, so the holder is glued or inline either way,
    and the board being bought is larger than t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
    [gen_perf.py]
2026-11-03 Spread the bottom row across the width
    行26 was packed into 列2-19 with 列20-35 empty. It now reads
    J3(8,10) → F1(12,16) → C1(19,21) → C2(23,25), so the fuse lands near
    列16 as asked and every part has clear space around it.
    (16,25) itself could not take a pin — that hole is on the bare GND
    trunk — so the parts sit on 行26 and the trunk moved instead.
    Two placements are deliberate and should not be tidied away:
    - Trunk A starts at 列13, and lane F detours along 行24 to leave
    (10,25) empty. Both keep bare tinned wire off the holes next to
    (10,26) J3.1 and (12,26) F1.2, which carry LiPo+ upstream of the
    fuse. A solder whisker there shorts the pack with nothing in seri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
    [gen_perf.py]
2026-11-03 Widen SW1/SW2 to 3x2 holes and say why diagonal
    The parts table says to bend the 6.5 x 4.5mm legs out to 7.62 x 5.08mm,
    but the perfboard layout had them on 2 x 2 holes, 5.08 square. The
    layout now matches: SW1 at (7,6)-(10,8), SW2 at (7,12)-(10,14).
    Widening 6.5 to 7.62 strains the legs less than squeezing to 5.08, and
    the ground pin stays on bus lane F at 列10.
    Also answered the question the old note raised without settling: the
    four legs are two terminals of two legs each, and pressing joins the
    terminals. Picking two legs of one terminal gives a button that reads
    as held down forever. The diagonal works whichever axis the internal
    pairing runs along, which is the whole reason for the r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
2026-11-03 Spell out which side of J2 is input
    The figure never said, and getting it backwards is fatal: 12V on the
    OUT side comes back through the inductor and the high-side body diode
    to IN, and IN is what feeds the Pico's VBUS. The page now has the four
    terminals with their holes and nets — IN+ (35,9) and IN− (35,5) on the
    right, OUT+ (28,9) and OUT− (28,5) on the left, plus in each column —
    and says to orient the module by its own silkscreen, since the figure
    is mirrored from the KiCad footprint (OUT is left here so the +5V run
    to the Pico stays short).
    The terminal names are read out of gen_buck_fp.py's PADS instead of
    being retyped, and the netlist is then checked to agree: IN+ must be
    V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
    [gen_perf.py]
2026-11-03 Rotate J2 instead of mirroring it
    I had drawn J2 with OUT on the left but plus still on the bottom, which
    is the footprint mirrored left-to-right. A part cannot be mirrored —
    only turned over, and turning this one over puts the component side
    (inductor, IC, trimpot) against the board, where the 5.0V trimpot
    cannot be reached. Keeping the component side up and rotating 180
    degrees swaps the rows as well, so plus goes to the top:
    OUT+ (28,5) left-top IN+ (35,5) right-top
    OUT− (28,9) left-bottom IN− (35,9) right-bottom
    The page now says this is a rotation, not a mirror, and why turning it
    over is not an option.
    Knock-on fixes, all from the ground pins moving off 行5:
    - lane E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
    [gen_perf.py]
2026-11-04 Say which wiring segments can be bare wire
    裸線で引けるかを配線リストの列として出す。判定は3つ: 直線上に別ネットの
    ピンを踏むか、裸のGND母線と交差するか、ヒューズより前のLiPo+か。
    配線リスト同士の交差は片方が被覆なら足りるので「裸可」に留める。
    28区間のうち裸8・裸可2・被覆18。
    これを入れたのは、GND母線を交差相手に数えずに「裸でよい」と判断する事故が
    あったため。配線リストの線同士しか比べていなかった。母線は裸と決めてある
    ので逃げ場がなく、BTN_MODE (7,6)-(20,6) は (19,6) で母線Cに直に当たる。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
2026-11-12 Name the wire for each segment, not just bare or insulated
    配線リストに「材」列を足し、UEW / AWG24 / すずメッキ / 部品の足 のどれかを
    区間ごとに書く。「絶縁」列だけでは、被覆が要ると分かっても何を使うのかが
    分からなかった。
    絶縁の要否と太さの要否は別の軸なので分けて決める。太さは電流が流れる
    ネットかどうかで、降圧モジュール(J2)・LiPo(J3)・ヒューズ(F1)のピンを含む
    ネットとして引く。この3部品を通る電流は全部そこに乗り、信号ネットはどれにも
    触らない。J1(Nano TX)はCRSFとVBATが同じコネクタに同居しているの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
